brzyzek/arb/2_HARDWARE/02_BOM/brzk-arb-001-BOM.ods

LEVEL | FIND NUMBER | PART NUMBER | PART DESCRIPTION | REF DES | QUANTITY | UOM | UNIT PRICE | PRICE | VENDOR LINK | LSCS PART NUMBER | PHASE | COMMENT
1 | 0001 | brzk-arb-cca | ARBITRARY WAVEFORM GENERATOR CIRCUIT CARD ASSEMBLY | A1 | 1 | EACH | $183.86 | $183.86 |  | N/A | PROTOTYPE
2 | 0001 | brzk-arb-pcb | ARBITRARY WAVEFORM GENERATOR PRINTED CIRCUIT BOARD |  | 1 | EACH | $40.00 | $40.00 |  | N/A | PROTOTYPE
2 | 0002 | X322512MSB4SI | FOUR PIN CRYSTAL, GND ON PINS 2 AND 4, SMALL SYMBOL | Y2 | 1 | EACH | $0.67 | $0.67 | https://www.lcsc.com/product-detail/C9002.html | C9002 | COTS
2 | 0003 | Q13FC13500004 | TWO PIN CRYSTAL, SMALL SYMBOL | Y1 | 1 | EACH | $0.90 | $0.90 | https://www.lcsc.com/product-detail/C32346.html | C32346 | COTS
2 | 0004 | TS-1187A-B-A-B | PUSH BUTTON SWITCH, GENERIC, FOUR PINS | SW1 | 1 | EACH | $0.38 | $0.38 | https://www.lcsc.com/product-detail/C318884.html | C318884 | COTS
2 | 0005 | 0603WAF5101T5E | RESISTOR, SMALL US SYMBOL | R93,R94 | 2 | EACH | $0.11 | $0.22 | https://www.lcsc.com/product-detail/C23186.html | C23186 | COTS
2 | 0006 | RT0603BRE0750RL | RESISTOR, SMALL US SYMBOL | R86 | 1 | EACH | $0.18 | $0.18 | https://www.digikey.com/en/products/detail/yageo/RT0603BRE0750RL/5928059 | C849792 | COTS
2 | 0007 | 0603WAF1243T5E | RESISTOR, SMALL US SYMBOL | R83 | 1 | EACH | $0.11 | $0.11 | http://www.lcsc.com/product-detail/C22788.html | C22788 | COTS
2 | 0008 | RT0603BRD07226RL | RESISTOR, SMALL US SYMBOL | R65,R66,R67,R68 | 4 | EACH | $0.48 | $1.92 | https://www.lcsc.com/product-detail/C861234.html | C861234 | COTS
2 | 0009 | 0603WAF2001T5E | RESISTOR, SMALL US SYMBOL | R59 | 1 | EACH | $0.11 | $0.11 | https://www.lcsc.com/product-detail/C22975.html | C22975 | COTS
2 | 0010 | 0603WAF3901T5E | RESISTOR, SMALL US SYMBOL | R58 | 1 | EACH | $0.11 | $0.11 | https://www.lcsc.com/product-detail/C23018.html | C23018 | COTS
2 | 0011 | RC0603FR-074K7L | RESISTOR, SMALL US SYMBOL | R48,R76,R77 | 3 | EACH | $0.11 | $0.33 | https://www.lcsc.com/product-detail/C99782.html | C99782 | COTS
2 | 0012 | 0603WAF1202T5E | RESISTOR, SMALL US SYMBOL | R47 | 1 | EACH | $0.11 | $0.11 | https://www.lcsc.com/product-detail/C22790.html (https://www.lcsc.com/product-detail/C99782.html) | C22790 | COTS
2 | 0013 | 0603WAF2051T5E | RESISTOR, SMALL US SYMBOL | R44 | 1 | EACH | $0.11 | $0.11 | https://www.lcsc.com/product-detail/C22900.html (https://www.lcsc.com/product-detail/C99782.html) | C22900 | COTS
2 | 0014 | RC0603FR-071KL | RESISTOR, SMALL US SYMBOL | R42,R70,R72 | 3 | EACH | $0.11 | $0.33 | https://www.lcsc.com/product-detail/C22548.html (https://www.lcsc.com/product-detail/C99782.html) | C22548 | COTS
2 | 0015 | 0603WAF2200T5E | RESISTOR, SMALL US SYMBOL | R38,R39,R40,R52,R53 | 5 | EACH | $0.11 | $0.55 | https://www.lcsc.com/product-detail/C22962.html | C22962 | COTS
2 | 0016 | 0603WAF249JT5E | RESISTOR, SMALL US SYMBOL | R19,R21,R27,R28,R61,R62,R63,R64 | 8 | EACH | $0.11 | $0.88 | https://www.lcsc.com/product-detail/C22916.html | C22916 | COTS
2 | 0017 | RC0603FR-071M3L | RESISTOR, SMALL US SYMBOL | R13 | 1 | EACH | $0.10 | $0.10 | https://www.lcsc.com/product-detail/C245931.html | C245931 | COTS
2 | 0018 | RT0603DRE07104KL | RESISTOR, SMALL US SYMBOL | R12 | 1 | EACH | $0.07 | $0.07 | https://www.lcsc.com/product-detail/C862849.html | C862849 | COTS
2 | 0019 | 0603WAF8452T5E | RESISTOR, SMALL US SYMBOL | R9 | 1 | EACH | $0.01 | $0.01 | https://www.lcsc.com/product-detail/C23118.html | C23118 | COTS
2 | 0020 | 0603WAF9763T5E | RESISTOR, SMALL US SYMBOL | R8 | 1 | EACH | $0.12 | $0.12 | https://www.lcsc.com/product-detail/C48922.html | C48922 | COTS
2 | 0021 | 0603WAJ0000T5E | RESISTOR, SMALL US SYMBOL | R6,R7,R10,R11,R14,R15,R16,R17,R29,R50,R51,R73,R74,R78,R79,R80,R81,R82,R85,R91,R95,R96,R97,R98,R99,R100,R101,R102 | 28 | EACH | $0.10 | $2.80 | https://www.lcsc.com/product-detail/C15402.html | C15402 | COTS
2 | 0022 | RC0603FR-07100RL | RESISTOR, SMALL US SYMBOL | R5,R25,R26,R41 | 4 | EACH | $0.11 | $0.44 | https://www.lcsc.com/product-detail/C105588.html | C105588 | COTS
2 | 0023 | 0603WAF4990T5E | RESISTOR, SMALL US SYMBOL | R4,R69,R71,R87,R88,R89,R90 | 7 | EACH | $0.11 | $0.77 | https://www.lcsc.com/product-detail/C23065.html | C23065 | COTS
2 | 0024 | 0603WAF1002T5E | RESISTOR, SMALL US SYMBOL | R1,R2,R3,R18,R20,R22,R23,R24,R30,R31,R32,R33,R34,R35,R36,R37,R43,R45,R46,R49,R54,R55,R56,R57,R60,R75,R84,R92 | 28 | EACH | $0.10 | $2.80 | https://www.lcsc.com/product-detail/C25804.html | C25804 | COTS
2 | 0025 | LS0603-100J-N | INDUCTOR, SMALL SYMBOL | L3,L4 | 2 | EACH | $0.75 | $1.50 | https://www.lcsc.com/product-detail/C373750.html | C373750 | COTS
2 | 0026 | FTC252010S4R7MBCA,LQM18PN4R7MFRL | INDUCTOR, SMALL SYMBOL | L1,L2 | 2 | EACH | $0.50 | $1.00 | https://www.lcsc.com/product-detail/C5832360.html | C5832360,C114862 | COTS
2 | 0027 | PH-00244 | GENERIC CONNECTOR, DOUBLE ROW, 02X05, ODD/EVEN PIN NUMBERING SCHEME (ROW 1 ODD NUMBERS, ROW 2 EVEN NUMBERS), SCRIPT GENERATED (KICAD-LIBRARY-UTILS/SCHLIB/AUTOGEN/CONNECTOR/) | J5 | 1 | EACH | $0.50 | $0.50 | https://www.lcsc.com/product-detail/C2829881.html | C2829881 | COTS
2 | 0028 | DOSIN-801-0050 | COAXIAL CONNECTOR (BNC, SMA, SMB, SMC, CINCH/RCA, LEMO, ...) | J4 | 1 | EACH | $0.74 | $0.74 | https://www.lcsc.com/product-detail/C521210.html | C521210 | COTS
2 | 0029 | KH-SMA-K513-G | COAXIAL CONNECTOR (BNC, SMA, SMB, SMC, CINCH/RCA, LEMO, ...) | J2,J3 | 2 | EACH | $0.58 | $1.16 | https://www.lcsc.com/product-detail/C411575.html | C411575 | COTS
2 | 0030 | FBMA-11-160808-300A25T | FERRITE BEAD, SMALL SYMBOL | FB2 | 1 | EACH | $2.00 | $2.00 | https://jlcpcb.com/partdetail/Kingcore-FBMA_11_160808300A25T/C491547 | C491547 | COTS | NOT IN STOCK
2 | 0031 | FBMA_11_160808101A20T | FERRITE BEAD, SMALL SYMBOL | FB1 | 1 | EACH | $2.00 | $2.00 | https://jlcpcb.com/partdetail/Kingcore-FBMA_11_160808101A20T/C491555 | C491555 | COTS | NOT IN STOCK
2 | 0032 | F.1206.00003/P2-1206R1TS2-09T-001 | LIGHT EMITTING DIODE | D1,D4,D5,D6,D7,D8 | 6 | EACH | $0.10 | $0.60 | https://www.lcsc.com/product-detail/C7496845.html | C7496845 | COTS
2 | 0033 | CL10C220JB8NNNC | UNPOLARIZED CAPACITOR, SMALL SYMBOL | C110 | 1 | EACH | $0.40 | $0.40 | https://www.lcsc.com/product-detail/C1653.html | C1653 | COTS
2 | 0034 | CL10A335KP8NNNC | UNPOLARIZED CAPACITOR, SMALL SYMBOL | C77 | 1 | EACH | $0.87 | $0.87 | https://www.lcsc.com/product-detail/C51412.html | C51412 | COTS
2 | 0035 | CL10C270JB8NNNC | UNPOLARIZED CAPACITOR, SMALL SYMBOL | C73,C75 | 2 | EACH | $0.25 | $0.50 | https://www.lcsc.com/product-detail/C1656.html | C1656 | COTS
2 | 0036 | CL10C150JB8NNNC | UNPOLARIZED CAPACITOR, SMALL SYMBOL | C43,C45 | 2 | EACH | $0.25 | $0.50 | https://www.lcsc.com/product-detail/C1644.html | C1644 | COTS
2 | 0037 | CC0603CRNPO9BN5R0 | UNPOLARIZED CAPACITOR, SMALL SYMBOL | C37,C95,C96,C106,C109 | 5 | EACH | $0.10 | $0.50 | https://www.digikey.com/en/products/detail/yageo/CC0603CRNPO9BN5R0/302788 | C327203 | COTS
2 | 0038 | CL10B224KB8NNNC | UNPOLARIZED CAPACITOR, SMALL SYMBOL | C20 | 1 | EACH | $0.77 | $0.77 | https://www.lcsc.com/product-detail/C64705.html | C64705 | COTS
2 | 0039 | CC0603BRNPO9BN6R8 | UNPOLARIZED CAPACITOR, SMALL SYMBOL | C19,C21 | 2 | EACH | $0.20 | $0.40 | https://www.lcsc.com/product-detail/C519114.html | C519114 | COTS
2 | 0040 | CC0603KRX7R9BB472 | UNPOLARIZED CAPACITOR, SMALL SYMBOL | C18 | 1 | EACH | $0.26 | $0.26 | https://www.lcsc.com/product-detail/C106218.html | C106218 | COTS
2 | 0041 | CL10B103KB8NNNC | UNPOLARIZED CAPACITOR, SMALL SYMBOL | C17 | 1 | EACH | $0.16 | $0.16 | https://www.lcsc.com/product-detail/C1589.html | C1589 | COTS
2 | 0042 | CL10A225KO8NNNC | UNPOLARIZED CAPACITOR, SMALL SYMBOL | C8,C9,C10,C13,C14,C38,C39 | 7 | EACH | $0.05 | $0.35 | https://www.lcsc.com/product-detail/C23630.html | C23630 | COTS
2 | 0043 | CL10B104JB8NNNC | UNPOLARIZED CAPACITOR, SMALL SYMBOL | C6,C16,C28,C31,C32,C33,C34,C35,C36,C40,C41,C44,C46,C47,C48,C50,C51,C52,C54,C55,C56,C57,C58,C59,C60,C64,C65,C66,C67,C71,C76,C78,C79,C80,C81,C82,C83,C84,C85,C86,C87,C88,C89,C90,C91,C92,C93,C94,C97,C98,C99,C100,C101,C102,C103,C104,C105,C107,C108,C111,C112,C113,C114 | 63 | EACH | $0.01 | $0.57 | https://www.lcsc.com/product-detail/C24452.html | C24452 | COTS
2 | 0044 | CL10A475KP8NNNC | UNPOLARIZED CAPACITOR, SMALL SYMBOL | C5,C15,C22,C23,C24,C25,C26,C27,C29,C30,C61,C62,C63,C68,C69,C70,C72,C74 | 18 | EACH | $0.01 | $0.09 | https://www.lcsc.com/product-detail/C1705.html | C1705 | COTS
2 | 0045 | CL10A106KP8NNNC | UNPOLARIZED CAPACITOR, SMALL SYMBOL | C4,C42 | 2 | EACH | $0.15 | $0.30 | https://www.lcsc.com/product-detail/C19702.html | C19702 | COTS
2 | 0046 | CL10A105KB8NNNC | UNPOLARIZED CAPACITOR, SMALL SYMBOL | C1,C2,C3,C7,C11,C12,C49,C53 | 8 | EACH | $0.05 | $0.40 | https://www.lcsc.com/product-detail/C15849.html | C15849 | COTS
2 | 0047 | TPD2E001DRLR | DUAL 1.5-PF, 5.5-V, Â±8-KV ESD PROTECTION DIODE WITH 1-NA MAX LEAKAGE & VCC PIN FOR USB 2.0 | U8 | 1 | EACH | $0.90 | $0.90 | https://www.lcsc.com/product-detail/C150526.html | C150526 | COTS
2 | 0048 | TMUX6104PWR | 5-PA ON-STATE LEAKAGE CURRENT, Â±16.5-V, 4:1, 1-CHANNEL PRECISION ANALOG MULTIPLEXER | U21,U26 | 2 | EACH | $2.91 | $5.82 | https://www.lcsc.com/product-detail/C2673388.html | C2673388 | COTS
2 | 0049 | TLV76133DCYR | 3.3V, 1A, LOW NOISE, HIGH-PSRR LDO REGULATOR, 2.5V...16V INPUT, SOT-223 | U2 | 1 | EACH | $1.19 | $1.19 | https://www.lcsc.com/product-detail/C7527500.html | C7527500 | COTS
2 | 0050 | TLV70325DBVR | 300-MA, HIGH-PSRR, LOW-IQ, LOW-DROPOUT VOLTAGE REGULATOR | U6 | 1 | EACH | $1.57 | $1.57 | https://www.lcsc.com/product-detail/C2877882.html | C2877882 | COTS
2 | 0051 | TLV70312DBVR | 300-MA, HIGH-PSRR, LOW-IQ, LOW-DROPOUT VOLTAGE REGULATOR | U5 | 1 | EACH | $0.74 | $0.74 | https://www.lcsc.com/product-detail/C2861352.html | C2861352 | COTS
2 | 0052 | TLV70333DBVR | 300-MA, HIGH-PSRR, LOW-IQ, LOW-DROPOUT VOLTAGE REGULATOR | U1,U3 | 2 | EACH | $0.62 | $1.24 | https://www.lcsc.com/product-detail/C2871194.html | C2871194 | COTS
2 | 0053 | LMK1C1103PWR | 3-CHANNEL OUTPUT LVCMOS BUFFER | U10 | 1 | EACH | $1.35 | $1.35 | https://www.lcsc.com/product-detail/C2873274.html | C2873274 | COTS
2 | 0054 | STM32F446ZET7 | STMICROELECTRONICS ARM CORTEX-M4 MCU, 512KB FLASH, 128KB RAM, 180 MHZ, 1.8-3.6V, 114 GPIO, LQFP144 | U11 | 1 | EACH | $10.64 | $10.64 | https://www.digikey.com/en/products/detail/stmicroelectronics/STM32F446ZET7/6207483 | C2970508 | COTS
2 | 0055 | MBRM120ET1G | SCHOTTKY DIODE | D2,D3 | 2 | EACH | $0.76 | $1.52 | https://www.lcsc.com/product-detail/C152484.html | C152484 | COTS
2 | 0056 | BAT54LT1G | SCHOTTKY BARRIER DIODE, SOT-32 | D9 | 1 | EACH | $0.51 | $0.51 | https://www.lcsc.com/product-detail/C94399.html | C94399 | COTS
2 | 0057 | TYPE-C-31-M-12 | USB 2.0-ONLY 16P TYPE-C RECEPTACLE CONNECTOR | J1 | 1 | EACH | $0.87 | $0.87 | https://www.lcsc.com/product-detail/C165948.html | C165948 | COTS
2 | 0058 | FT2232HL | HI SPEED DOUBLE CHANNEL USB UART/FIFO, LQFP-64 | U14 | 1 | EACH | $8.68 | $8.68 | https://www.lcsc.com/product-detail/C27882.html | C27882 | COTS
2 | 0059 | ADG1219BRJZ | LOW CAPACITANCE, LOW CHARGE INJECTION, Â±15 V/12 V ICMOSÂ® SPDT IN SOT-23 | U9,U24 | 2 | EACH | $4.49 | $8.98 | https://www.lcsc.com/product-detail/C579007.html | C579007 | COTS
2 | 0060 | AD9850BRSZ | CMOS, 125 MHZ, COMPLETE DDS SYNTHESIZER, SSOP-28 | U17 | 1 | EACH | $15.26 | $15.26 | https://www.lcsc.com/product-detail/C18731.html | C18731 | COTS
2 | 0061 | AD9744ARUZRL7 | 210MSPS 14BIT DAC, TSSOP-28 | U18 | 1 | EACH | $9.47 | $9.47 | https://www.lcsc.com/product-detail/C461519.html | C461519 | COTS
2 | 0062 | W25Q128JVSIQ | 128MB SERIAL FLASH MEMORY, STANDARD/DUAL/QUAD SPI, SOIC-8 | U15,U16 | 2 | EACH | $1.14 | $2.28 | https://www.lcsc.com/product-detail/C97521.html | C97521 | COTS
2 | 0063 | TPS65131RGE | SPLIT-RAIL CONVERTER WITH DUAL, POSITIVE AND NEGATIVE OUTPUTS (750MA TYP, SWITCH CURRENT LIMIT 1950MA TYP),), 2.7-5.5V, VQFN-24 | U7 | 1 | EACH | $0.87 | $0.87 | https://www.lcsc.com/product-detail/C87663.html | C87663 | COTS
2 | 0064 | TPL0401B-10DCKR | 128-TAPS SINGLE-CHANNEL DIGITAL POTENTIOMETER, I2C INTERFACE, SC-70-6 | U22 | 1 | EACH | $1.13 | $1.13 | https://www.lcsc.com/product-detail/C2666599.html | C2666599 | COTS
2 | 0065 | THS3491IDDAR | 900-MHZ, 500-MA HIGH-POWER OUTPUT CURRENT FEEDBACK OPERATIONAL AMPLIFIER, SOIC-8 | U23 | 1 | EACH | $13.78 | $13.78 | https://www.digikey.com/en/products/detail/texas-instruments/THS3491IDDAR/8625496 | C2058693 | COTS
2 | 0066 | LM6171BIMX/NOPB | HIGH SPEED LOW POWER LOW DISTORTION VOLTAGE FEEDBACK AMPLIFIER, SOIC-8 | U19,U20,U25 | 3 | EACH | $5.21 | $15.63 | https://www.digikey.com/en/products/detail/texas-instruments/LM6171BIMX-NOPB/367300 | C2058493 | COTS
2 | 0067 | LM3880MF-1AA/NOPB | SIMPLE POWER SEQUENCER, SOT-23-6 | U4 | 1 | EACH | $0.67 | $0.67 | https://www.lcsc.com/product-detail/C486059.html | C486059 | COTS
2 | 0068 | ICE40UP5K-SG48I | ICE40 ULTRAPLUS FPGA, 5280 LUTS, 1.2V, 48-PIN QFN | U12 | 1 | EACH | $7.22 | $7.22 | https://www.lcsc.com/product-detail/C2678152.html | C2678152 | COTS
2 | 0069 | ASE-100.000MHz | 3.3V CMOS SMD CRYSTAL CLOCK OSCILLATOR, ABRACON | X2 | 1 | EACH | $2.00 | $2.00 | https://www.mouser.com/ProductDetail/ABRACON/ASE-100.000MHZ-LC-T?qs=gt1LBUVyoHkjVhbV30nHAA%3D%3D | C17666082 | COTS
2 | 0070 | ASE-10.000MHz | 3.3V CMOS SMD CRYSTAL CLOCK OSCILLATOR, ABRACON | X1 | 1 | EACH | $1.50 | $1.50 | https://www.mouser.com/ProductDetail/ABRACON/ASE-10.000MHZ-LC-T?qs=ShQ8XZQtgRupHfFA9Odmpg%3D%3D | C1995292 | COTS
2 | 0071 | 93LC56BT-I_OT | IC EEPROM 2KBIT MIC WIRE SOT23-6 | U13 | 1 | EACH | $0.45 | $0.45 | https://www.lcsc.com/product-detail/C190271.html | C190271 | COTS
2 | 9001 | brzk-arb-001-sch | ARBITRARY WAVEFORM GENERATOR SCHEMATIC |  | 0 | REF | $0.00 | $0.00 | N/A | N/A | PROTOTYPE
