brzyzek/arb/2_HARDWARE/04_PINS/ARB_PIN_MAP.ods

Sheet: MCU
PIN NUMBER | PIN NAME | PIN TYPE | SIGNAL NAME | SIGNAL TYPE | VOLTAGE | DIRECTION (IAW STM32) | STM32 RESOURCE | COMMENTS
1 | PE2 | I/O | QSPI_IO2_MCU_FLASH_3P3 | LVCMOS33 | 3.3 | BIDIR | QUADSPI_BK1_IO2
2 | PE3 | I/O | NC
3 | PE4 | I/O | NC
4 | PE5 | I/O | NC
5 | PE6 | I/O | NC
6 | VBAT | Power | 3P3V_D | POWER | 3.3 | IN | VBAT
7 | PC13 | I/O | NC
8 | PC14-OSC32_IN | I/O | CLK_32K_OSC_MCU_IN | OSCILLATOR | X | IN | 32KHZ OSCILLATOR
9 | PC15-OSC32_OUT | I/O | CLK_32K_OSC_MCU_OUT | OSCILLATOR | X | OUT | 32KHZ OSCILLATOR
10 | PF0 | I/O | NC
11 | PF1 | I/O | NC
12 | PF2 | I/O | NC
13 | PF3 | I/O | NC
14 | PF4 | I/O | NC
15 | PF5 | I/O | NC
16 | VSS | Power | GND_D | GROUND | 0 | IN | GROUND
17 | VDD | Power | 3P3V_D | POWER | 3.3 | IN | POWER
18 | PF6 | I/O | QSPI_IO3_MCU_FLASH_3P3 | LVCMOS33 | 3.3 | BIDIR | QUADSPI_BK1_IO3
19 | PF7 | I/O | NC
20 | PF8 | I/O | QSPI_IO0_MCU_FLASH_3P3 | LVCMOS33 | 3.3 | BIDIR | QUADSPI_BK1_IO0
21 | PF9 | I/O | QSPI_IO1_MCU_FLASH_3P3 | LVCMOS33 | 3.3 | BIDIR | QUADSPI_BK1_IO1
22 | PF10 | I/O | NC
23 | PH0-OSC_IN | I/O | CLK_10MHZ_DIST_MCU_3P3 | LVCMOS33 | 3.3 | IN | OSCILLATOR IN
24 | PH1-OSC_OUT | I/O | NC
25 | NRST | Reset | GPIO_RST_MCU_3P3_L | LVCMOS33 | 3.3 | IN | NRST | SEND TO SWITCH THAT GNDS, NORMALLY PULLED UP TO VDD
26 | PC0 | I/O | SPI_CS_MCU_FPGA_3P3_L | LVCMOS33 | 3.3 | OUT | GPIO_OUT | USED FOR SPI1 CHIP SELECT TO FPGA
27 | PC1 | I/O | SPI_MOSI_MCU_FPGA_3P3 | LVCMOS33 | 3.3 | OUT | SPI2_MOSI
28 | PC2 | I/O | SPI_MISO_FPGA_MCU_3P3 | LVCMOS33 | 3.3 | IN | SPI2_MISO
29 | PC3 | I/O | SPI_CS_MCU_FLASH_3P3_L | LVCMOS33 | 3.3 | OUT | GPIO_OUT | USED FOR SPI1 CHIP SELECT TO FLASH
30 | VDD | Power | 3P3V_D | POWER | 3.3 | IN | POWER
31 | VSSA | Power | GND_A | GROUND | 0 | IN | GROUND
32 | VREF+ | Power | 3P3V_D | POWER | 3.3 | IN | POWER
33 | VDDA | Power | 3P3V_A | POWER | 3.3 | IN | POWER
34 | PA0-WKUP | I/O | NC
35 | PA1 | I/O | NC
36 | PA2 | I/O | UART_MCUTX_FTDIRX_3P3 | LVCMOS33 | 3.3 | OUT | USART2_TX
37 | PA3 | I/O | UART_FTDITX_MCURX_3P3 | LVCMOS33 | 3.3 | IN | USART2_RX
38 | VSS | Power | GND_D | GROUND | 0 | IN | GROUND
39 | VDD | Power | 3P3V_D | POWER | 3.3 | IN | POWER
40 | PA4 | I/O | ANALOG_DAC1_MCU_AMUX1 | ANALOG | 0V TO 3V | OUT | DAC_OUT1
41 | PA5 | I/O | ANALOG_DAC2_MCU_AMUX3 | ANALOG | 0V TO 3V | OUT | DAC_OUT2
42 | PA6 | I/O | ANALOG_CAL-ADC_AMUX2_MCU | ANALOG | 0V TO 3V | IN | ADC1_IN6
43 | PA7 | I/O | GPIO_SEL1_MCU_AMUX3_3P3 | LVCMOS33 | 3.3 | OUT | GPIO_OUT
44 | PC4 | I/O | NC
45 | PC5 | I/O | NC
46 | PB0 | I/O | NC
47 | PB1 | I/O | NC
48 | PB2 | I/O | GPIO_BOOT1_SW_MCU_3P3_L QSPI_CLK_MCU_FLASH_3P3 | LVCMOS33 | 3.3 | IN OUT | BOOT1 QUADSPI_CLK
49 | PF11 | I/O | GPIO_CFG_DONE_FPGA_MCU_3P3 | LVCMOS33 | 3.3 | IN | GPIO_IN
50 | PF12 | I/O | GPIO_FPGARST_MCU_FPGA_3P3_L | LVCMOS33 | 3.3 | OUT | GPIO_OUT
51 | VSS | Power | GND_D | GROUND | 0 | IN | GROUND
52 | VDD | Power | 3P3V_D | POWER | 3.3 | IN | POWER
53 | PF13 | I/O | NC
54 | PF14 | I/O | GPIO_CLK_EN_MCU_FPGA_3P3 | LVCMOS33 | 3.3 | OUT | GPIO_OUT
55 | PF15 | I/O | GPIO_AMP-PD_MCU_AMP2_3P3 | LVCMOS33 | 3.3 | OUT | GPIO_OUT
56 | PG0 | I/O | NC
57 | PG1 | I/O | NC
58 | PE7 | I/O | NC
59 | PE8 | I/O | NC
60 | PE9 | I/O | NC
61 | VSS | Power | GND_D | GROUND | 0 | IN | GROUND
62 | VDD | Power | 3P3V_D | POWER | 3.3 | IN | POWER
63 | PE10 | I/O | NC
64 | PE11 | I/O | GPIO_SEL0_MCU_AMUX3_3P3 | LVCMOS33 | 3.3 | OUT | GPIO_OUT
65 | PE12 | I/O | GPIO_EN_MCU_AMUX3_3P3 | LVCMOS33 | 3.3 | OUT | GPIO_OUT
66 | PE13 | I/O | GPIO_EN_MCU_AMUX2_3P3 | LVCMOS33 | 3.3 | OUT | GPIO_OUT
67 | PE14 | I/O | GPIO_SEL_MCU_AMUX2_3P3 | LVCMOS33 | 3.3 | OUT | GPIO_OUT
68 | PE15 | I/O | NC
69 | PB10 | I/O | I2C_SCL_MCU_POT_3P3 | LVCMOS33 | 3.3 | OUT | I2C1_SCL
70 | PB11 | I/O | I2C_SDA_MCU_POT_3P3 | LVCMOS33 | 3.3 | BIDIR | I2C1_SDA
71 | VCAP_1 | Power | GND_D | GROUND | 0 | IN | GROUND | GND THROUGH 2.2UF CAPACITOR
72 | VDD | Power | 3P3V_D | POWER | 3.3 | IN | POWER
73 | PB12 | I/O | GPIO_100M-EN_MCU_100M-OSC_3P3 | LVCMOS33 | 3.3 | OUT | GPIO_OUT
74 | PB13 | I/O | SPI_SCLK_MCU_FPGA_3P3 | LVCMOS33 | 3.3 | OUT | SPI2_SCK
75 | PB14 | I/O | GPIO_RST_MCU_DDS_3P3 | LVCMOS33 | 3.3 | OUT | GPIO_OUT
76 | PB15 | I/O | GPIO_D7_MCU_DDS_3P3 | LVCMOS33 | 3.3 | OUT | GPIO_OUT
77 | PD8 | I/O | GPIO_D6_MCU_DDS_3P3 | LVCMOS33 | 3.3 | OUT | GPIO_OUT
78 | PD9 | I/O | GPIO_D5_MCU_DDS_3P3 | LVCMOS33 | 3.3 | OUT | GPIO_OUT
79 | PD10 | I/O | GPIO_D4_MCU_DDS_3P3 | LVCMOS33 | 3.3 | OUT | GPIO_OUT
80 | PD11 | I/O | GPIO_D1_MCU_DDS_3P3 | LVCMOS33 | 3.3 | OUT
81 | PD12 | I/O | GPIO_D2_MCU_DDS_3P3 | LVCMOS33 | 3.3 | OUT
82 | PD13 | I/O | NC
83 | VSS | Power | GND_D | GROUND | 0 | IN | GROUND
84 | VDD | Power | 3P3V_D | POWER | 3.3 | IN | POWER
85 | PD14 | I/O | NC
86 | PD15 | I/O | NC
87 | PG2 | I/O | GPIO_FQ-UD_MCU_DDS_3P3 | LVCMOS33 | 3.3 | OUT | GPIO_OUT
88 | PG3 | I/O | GPIO_D0_MCU_DDS_3P3 | LVCMOS33 | 3.3 | OUT | GPIO_OUT
89 | PG4 | I/O | NC |  |  |  | GPIO_OUT
90 | PG5 | I/O | NC |  |  |  | GPIO_OUT
91 | PG6 | I/O | QSPI_NCS_MCU_FLASH_3P3 | LVCMOS33 | 3.3 | OUT | QUADSPI_BK1_NCS
92 | PG7 | I/O | NC
93 | PG8 | I/O | NC
94 | VSS | Power | GND_D | GROUND | 0 | IN | GROUND
95 | VDDUSB | Power | 3P3V_D | POWER | 3.3 | IN | POWER
96 | PC6 | I/O | NC
97 | PC7 | I/O | NC
98 | PC8 | I/O | NC
99 | PC9 | I/O | NC
100 | PA8 | I/O | NC
101 | PA9 | I/O | NC
102 | PA10 | I/O | NC
103 | PA11 | I/O | GPIO_D3_MCU_DDS_3P3 | LVCMOS33 | 3.3 | OUT | GPIO_OUT
104 | PA12 | I/O | GPIO_W-CLK_MCU_DDS_3P3 | LVCMOS33 | 3.3 | OUT | GPIO_OUT
105 | PA13 | I/O | JTAG_MCU_TMS_3P3 | LVCMOS33 | 3.3 | IN | JTAG_TMS
106 | VCAP_2 | Power | GND_D | GROUND | 0 | IN | GROUND | GND THROUGH 2.2UF CAPACITOR
107 | VSS | Power | GND_D | GROUND | 0 | IN | GROUND
108 | VDD | Power | 3P3V_D | POWER | 3.3 | IN | POWER
109 | PA14 | I/O | JTAG_MCU_TCK_3P3 | LVCMOS33 | 3.3 | IN | JTAG_TCK
110 | PA15 | I/O | JTAG_MCU_TDI_3P3 | LVCMOS33 | 3.3 | IN | JTAG_TDI
111 | PC10 | I/O | NC
112 | PC11 | I/O | GPIO_SW-SEL_MCU_CLKMUX_3P3 | LVCMOS33 | 3.3 | OUT | GPIO_OUT
113 | PC12 | I/O | NC
114 | PD0 | I/O | NC
115 | PD1 | I/O | NC
116 | PD2 | I/O | NC
117 | PD3 | I/O | NC
118 | PD4 | I/O | NC
119 | PD5 | I/O | NC
120 | VSS | Power | GND_D | GROUND | 0 | IN | POWER
121 | VDD | Power | 3P3V_D | POWER | 3.3 | IN | POWER
122 | PD6 | I/O | GPIO_SEL1_MCU_AMUX1_3P3 | LVCMOS33 | 3.3 | OUT | GPIO_OUT
123 | PD7 | I/O | GPIO_SEL0_MCU_AMUX1_3P3 | LVCMOS33 | 3.3 | OUT | GPIO_OUT
124 | PG9 | I/O | NC
125 | PG10 | I/O | NC
126 | PG11 | I/O | NC
127 | PG12 | I/O | GPIO_EN_MCU_AMUX1_3P3 | LVCMOS33 | 3.3 | OUT | GPIO_OUT
128 | PG13 | I/O | NC
129 | PG14 | I/O | NC
130 | VSS | Power | GND_D | GROUND | 0 | IN | POWER
131 | VDD | Power | 3P3V_D | POWER | 3.3 | IN | POWER
132 | PG15 | I/O | NC
133 | PB3 | I/O | JTAG_MCU_TDO_3P3 | LVCMOS33 | 3.3 | OUT | JTAG_TDO
134 | PB4 | I/O | NC
135 | PB5 | I/O | NC
136 | PB6 | I/O | NC
137 | PB7 | I/O | NC
138 | BOOT0 | Boot | GPIO_BOOT0_SW_MCU_3P3_L | LVCMOS33 | 3.3 | IN | BOOT0 | CHECK IF WE NEED TO PULL THIS HIGH OR IF IT’S PULLED INTERNALLY
139 | PB8 | I/O | NC
140 | PB9 | I/O | NC
141 | PE0 | I/O | NC
142 | PE1 | I/O | NC
143 | PDR_ON | Reset | GPIO_PDRON_SW_MCU_3P3_L | LVCMOS33 | 3.3 | IN | POWER DOWN RESET | PULL UP TO VDD THROUGH 10K RES
144 | VDD | Power | 3P3V_D | POWER | 3.3 | IN | POWER

Sheet: FPGA
PIN NUMBER | PIN NAME | PIN TYPE | SIGNAL NAME | SIGNAL TYPE | VOLTAGE | DIRECTION (IAW FPGA) | DIFFERNETIAL PAIR | FPGA BANK | COMMENTS
1 | VCCIO_2 | VCCIO | 3P3V_D | POWER | 3.3 | IN | COMP_of_IOB_8a | 2
2 | IOB_6a | PIO | NC |  | 3.3 |  | TRUE_of_IOB_9b | 2
3 | IOB_9b | DPIO | NC |  | 3.3 |  | N/A | 2
4 | IOB_8a | DPIO | NC |  | 3.3 |  | COMP_of_IOB_12a | 2
5 | VCC | VCC | 1P2V_D | POWER | 1.2 | IN | N/A | VCC
6 | IOB_13b | DPIO | NC |  | 3.3 |  | N/A | 1
7 | CDONE | CONFIG | GPIO_CFG_DONE_FPGA_MCU_3P3 | LVCMOS33 | 3.3 | OUT | N/A | 1 | Send to MCU
8 | creset_b | CONFIG | GPIO_FPGARST_MCU_FPGA_3P3_L | LVCMOS33 | 3.3 | IN | N/A | 1 | Send to MCU (tied to SPI_VCCIO)
9 | IOB_16a | PIO | NC |  | 3.3 |  | N/A | 1
10 | IOB_18a | PIO | NC |  | 3.3 |  | TRUE_of_IOB_23b | 1
11 | IOB_20a | PIO | NC |  | 3.3 |  | TRUE_of_IOB_25b | 1
12 | IOB_22a | DPIO | GPIO_DACB11_FPGA_DAC_3P3 | LVCMOS33 | 3.3 | OUT | N/A | 1
13 | IOB_24a | DPIO | GPIO_DACSLEEP_FPGA_DAC_3P3 | LVCMOS33 | 3.3 | OUT | N/A | 1 | ACTIVE HIGH TO SLEEP, DAC HAS PULL DOWN CIRCUIT,
14 | IOB_32a_SPI_SO | DPIO/CONFIG_SPI | SPI_MISO_FPGA_MCU_3P3 | LVCMOS33 | 3.3 | OUT | N/A | 1 | Send to MCU + FLASH
15 | IOB_34a_SPI_SCK | DPIO/CONFIG_SPI | SPI_SCLK_MCU_FPGA_3P3 | LVCMOS33 | 3.3 | IN | N/A | 1 | Send to MCU + FLASH
16 | IOB_35b_SPI_SS | DPIO/CONFIG_SPI | SPI_CS_MCU_FPGA_3P3_L | LVCMOS33 | 3.3 | IN | N/A | 1 | Send to MCU + FLASH
17 | IOB_33b_SPI_SI | DPIO/CONFIG_SPI | SPI_MOSI_MCU_FPGA_3P3 | LVCMOS33 | 3.3 | IN | N/A | 1 | Send to MCU + FLASH
18 | IOB_31b | PIO | NC |  | 3.3 |  | COMP_of_IOB_24a | 1
19 | IOB_29b | PIO | NC |  | 3.3 |  | COMP_of_IOB_22a | 1
20 | IOB_25b_G3 | DPIO/GBIN | NC |  | 3.3 |  | N/A | 1
21 | IOB_23b | DPIO | NC |  | 3.3 |  | TRUE_of_IOT_36b | 1
22 | SPI_Vccio1 | VCCIO | 3P3V_D | POWER | 3.3 | IN | N/A | 1
23 | IOT_37a | DPIO/I3C | NC |  | 3.3 |  | COMP_of_IOT_37a | 0
24 | VPP_2V5 | VPP | 2P5V_D | POWER | 2.5 | IN | TRUE_of_IOT_38b | VPP
25 | IOT_36b | DPIO/I3C | GPIO_DACB0_FPGA_DAC_3P3 | LVCMOS33 | 3.3 | OUT | COMP_of_IOT_39a | 0
26 | IOT_39a | DPIO | GPIO_DACB1_FPGA_DAC_3P3 | LVCMOS33 | 3.3 | OUT | N/A | 0
27 | IOT_38b | DPIO | GPIO_DACB2_FPGA_DAC_3P3 | LVCMOS33 | 3.3 | OUT | N/A | 0
28 | IOT_41a | PIO | GPIO_DACB3_FPGA_DAC_3P3 | LVCMOS33 | 3.3 | OUT | N/A | 0
29 | VCCPLL | VCCPLL | 1P2V_D | POWER | 1.2 | IN | COMP_of_IOT_43a
30 | VCC | VCC | 1P2V_D | POWER | 1.2 | IN | TRUE_of_IOT_42b | VCC
31 | IOT_42b | DPIO | GPIO_DACB4_FPGA_DAC_3P3 | LVCMOS33 | 3.3 | OUT | N/A | 0
32 | IOT_43a | DPIO | NC |  | 3.3 |  | COMP_of_IOT_45a | 0
33 | VCCIO_0 | VCCIO | 3P3V_D | POWER | 3.3 | IN | N/A | 0
34 | IOT_44b | DPIO | GPIO_DACB5_FPGA_DAC_3P3 | LVCMOS33 | 3.3 | OUT | COMP_of_IOT_49a | 0
35 | IOT_46b_G0 | DPIO/GBIN | CLK_10MHZ_DIST_FPGA_3P3 | LVCMOS33 | 3.3 | IN | TRUE_of_IOT_44b | 0 | G0 as Global Clock Buffer In
36 | IOT_48b | DPIO | GPIO_DACB6_FPGA_DAC_3P3 | LVCMOS33 | 3.3 | OUT | COMP_of_IOT_51a | 0
37 | IOT_45a_G1 | DPIO/GBIN | GPIO_CLK_EN_MCU_FPGA_3P3 | LVCMOS33 | 3.3 | IN | N/A | 0
38 | IOT_50b | DPIO | GPIO_DACB7_FPGA_DAC_3P3 | LVCMOS33 | 3.3 | OUT | N/A | 0
39 | RGB0 | LED | GPIO_LED0_FPGA_LED_OD | OPEN DRAIN | 3.3 | OUT | N/A | 0 | Connect to Status LED
40 | RGB1 | LED | GPIO_LED1_FPGA_LED_OD | OPEN DRAIN | 3.3 | OUT | TRUE_of_IOT_50b | 0 | Connect to Status LED
41 | RGB2 | LED | GPIO_LED2_FPGA_LED_OD | OPEN DRAIN | 3.3 | OUT | TRUE_of_IOT_48b | 0 | Connect to Status LED
42 | IOT_51a | DPIO | GPIO_DACB8_FPGA_DAC_3P3 | LVCMOS33 | 3.3 | OUT | COMP_of_IOB_2a | 0
43 | IOT_49a | DPIO | GPIO_DACB9_FPGA_DAC_3P3 | LVCMOS33 | 3.3 | OUT | COMP_of_IOB_4a | 0
44 | IOB_3b_G6 | DPIO/GBIN | GPIO_DACB13_FPGA_DAC_3P3 | LVCMOS33 | 3.3 | OUT | N/A | 2
45 | IOB_5b | DPIO | GPIO_DACB12_FPGA_DAC_3P3 | LVCMOS33 | 3.3 | OUT | TRUE_of_IOB_3b | 2
46 | IOB_0a | PIO | NC |  | 3.3 |  | TRUE_of_IOB_5b | 2
47 | IOB_2a | DPIO | GPIO_DACCLK_FPGA_DAC_3P3 | LVCMOS33 | 3.3 | OUT | TRUE_of_IOB_11b | 2
48 | IOB_4a | DPIO | GPIO_DACB10_FPGA_DAC_3P3 | LVCMOS33 | 3.3 | OUT | COMP_of_IOB_10a | 2
Paddle | GND | GND | GND_D | GROUND | 0 |  | N/A | GND
Paddle | GND | GND | GND_D | GROUND | 0 |  | N/A | GND
Paddle | GND | GND | GND_D | GROUND | 0 |  | N/A | GND
 |  | Note: PIO = Programmable IO, DPIO = Differntial PIO, GBIN = Global In
