brzyzek/arb/2_HARDWARE/06_ANALYSIS/02_POWER_CONSUMPTION/POWER_ANALYSIS.ods

PART NUMBER | DESCRIPTION | REFERENCE DESIGNATOR | QUANTITY | 3P3V DIGITAL | 3P3V_FPGA | 3P3V ANALOG | 2P5V DIGITAL | 1P2V DIGITAL | 1P8V DIGITAL | 15V ANALOG | -15V ANALOG | COMMENTS
TOTAL CURRENT DRAW (A) |  |  |  | 0.48445 | 0.00030 | 0.10200 | 0.00010 | 0.00300 | 0.00000 | 0.26254 | 0.26254
TBD | LED | D1,D2 | 2 | 0.02000
TBD | RESISTOR, 10K OHMS | R1,R5,R7,R9,R12,R?,R?,R?,R?,R?,R? | 11 | 0.00132
TBD | RESISTOR, 1K OHMS | R8,R?,R? | 3 | 0.00330
TBD | RESISTOR, 4.7K OHMS | R11 | 1 | 0.00281
LM3880 | POWER SEQUENCER | U1 | 1 | 0.00003
ICE40UP5K-SG48ITR | FPGA, LATTICE ICE40UPK | U2 | 1 |  | 0.00030 |  | 0.00010 | 0.00300
STM32F446ZETx | MCU, STM32F446 | U3 | 1 | 0.24000 |  | 0.00100
AD9744 | DAC (FPGA) | U7 | 1 | 0.01500 |  | 0.03600 |  |  |  |  |  | MAY HAVE TO COMBINE THE ANALOG AND DIGITAL CURRENT NUMBERS
TMUX6104 | ANALOG MUX, SP4T | U?,U? | 2 |  |  |  |  |  |  | 0.00003 | 0.00003
THS34911DDA | OP-AMP, STAGE 2HIGH POWER | U? | 1 |  |  |  |  |  |  | 0.22500 | 0.22500 | PROBABLY < 150MA (INCL 17MA QUIESCENT CURRENT)
TPL0401B-10 | DIGITAL POTENTIOMETER | U? | 1 |  |  | 0.00500
LM6171D | OP-AMP, STAGE 1 | U?,U?,U? | 3 |  |  |  |  |  |  | 0.03750 | 0.03750 | PROBABLY < 150MA (INCL 2.5MA QUIESCENT CURRENT)
AD9850 | DAC (DDS) | U? | 1 | 0.00500 |  | 0.06000
93LC56BT-I_OT | EEPROM, FTDI | U? | 1 | 0.00100
FT2232HL | USB COMMUNICATION, FTDI | U? | 1 | 0.15000
ADG1219BRJZ | ANALOG MUX, SPDT | U?,U? | 2 |  |  |  |  |  |  | 0.00001 | 0.00001
ASE-100.000MHz | OSCILLATOR, 100MHZ | X? | 1 | 0.02500 |  |  |  |  |  |  |  | THIS MAY HAVE TO BE MOVED TO 3P3V ANALOG
ASE-10.000MHz | OSCILLATOR, 10MHZ | X? | 1 | 0.00700
TBD | OSCILLATOR, 32.768KHZ | Y2 | 1 | 0.00700
TBD | OSCILLATOR, 12MHZ | Y3 | 1 | 0.00700
