brzyzek/arb/2_HARDWARE/06_ANALYSIS/01_OP_AMP_SELECTION/OP_AMPS.ods

PART NUMBER | POWER SUPPLY VOLTAGE SPAN | INPUT VOLTAGE RANGE | OUTPUT VOLTAGE RANGE | OUTPUT CURRENT (mA) | SLEW RATE (V/US) | BW (-3DB) | UNITY GAIN STABLE | LINK
ADA4857-1 | 10.5 | -4V TO +4 | -VS+1.3 TO VS-1.3 | 50 | 2800 | 850M | Y | https://www.analog.com/en/ada4857-1
AD8012 | 12 | -5V TO +5 | -VS+1 TO VS-1 | 125 | 2250 | 350M | ? | https://www.analog.com/en/ad8012
LTC6268-10 |  |  |  |  |  |  | GAIN > 10 STABLE | https://www.analog.com/en/products/ltc6268-10.html#part-details
LT6553
ada4870
AD8016
 | https://www.analog.com/en/parametricsearch/11070#/p300=1k|5.5k&sort=s25,desc&d=s25|s6|s3|5002|4502|2606|300|2687|5055|2839|2840|5057|s16
 | ANALOG WITH PARAMETERS
