brzyzek/arb/2_HARDWARE/05_SIMULATION/analog.asc

I1: current; SINE(5M 5M 100Meg 0 0 180)
I3: current; SINE(5M 5M 100Meg)
R1: res; 499
R2: res; 499
R3: res; 1K
R4: res; 1K
R5: res; 120
R6: res; 50
R7: res; 50
R8: res; 120
R9: res; 1500
R10: res; 50
R11: res; 499
R12: res; 499
R13: res; 499
R14: res; 499
U1: UniversalOpAmp2; Avol=1Meg GBW=8000Meg Slew=8000Meg; Ilimit=50M Rail=0 Vos=0
U2: UniversalOpAmp2; Avol=1Meg GBW=8000Meg Slew=8000Meg; Ilimit=1 Rail=0 Vos=0
U3: UniversalOpAmp2; Avol=1Meg GBW=8000Meg Slew=8000Meg; Ilimit=50M Rail=0 Vos=0
V1: voltage; 5
V2: voltage; 5
V3: voltage; 12
V4: voltage; 12
V5: voltage; 3.3
V6: voltage; 3.1
V7: voltage; 2.0
V8: voltage; 15
V9: voltage; 15
Named nets: 0, N5V0, 5V0, 15V0, N15V0, N12V0, 12V0
.tran .001s
DIFFERENTIAL TO SINGLE ENDED OUTPUT AT +/- 1V
INVERTING BUFFER /W 5X GAIN (R9 SHOULD BE A DIFFERENTIAL POT)
3.3V REF
DAC REF
VOLTAGE OUTPUT = DAC REF - 3.3
DAC REF
