brzyzek/arb/2_HARDWARE/05_SIMULATION/DAC.asc

R1: res; 50R
U1: AD5770R
V1: voltage; 3.3
V2: voltage; 3.3
Named nets: 0
.tran 1s startup
ADDED AD5770R TO BE SIMILAR TO AD9744.
