brzyzek/arb/2_HARDWARE/05_SIMULATION/RVP+ATTN.asc

D1: diode
R1: res; 50K
R2: res; 1K
R3: res; 124K
R4: res; 500K
R15: res; 50
V1: voltage; SINE(0 12 100Meg)
V2: voltage; SINE(0 12 100Meg); Rser=2 Cpar=5p
Named nets: 0
.tran .001s
RIN @ ADC IS 50K OHMS
