brzyzek/arb/2_HARDWARE/05_SIMULATION/analog_noninvopamp.asc

I3: current; SINE(10M 10M 100Meg)
R3: res; 1K
R4: res; 2K
R5: res; 50R
U1: ADA4857
V1: voltage; 5
V2: voltage; 5
Named nets: 0, N5V0, 5V0
.tran .001s
