brzyzek/arb/2_HARDWARE/03_PCB/arb.kicad_pcb

## KiCad design 2_HARDWARE/03_PCB/arb.kicad_pcb (2025-10-13)

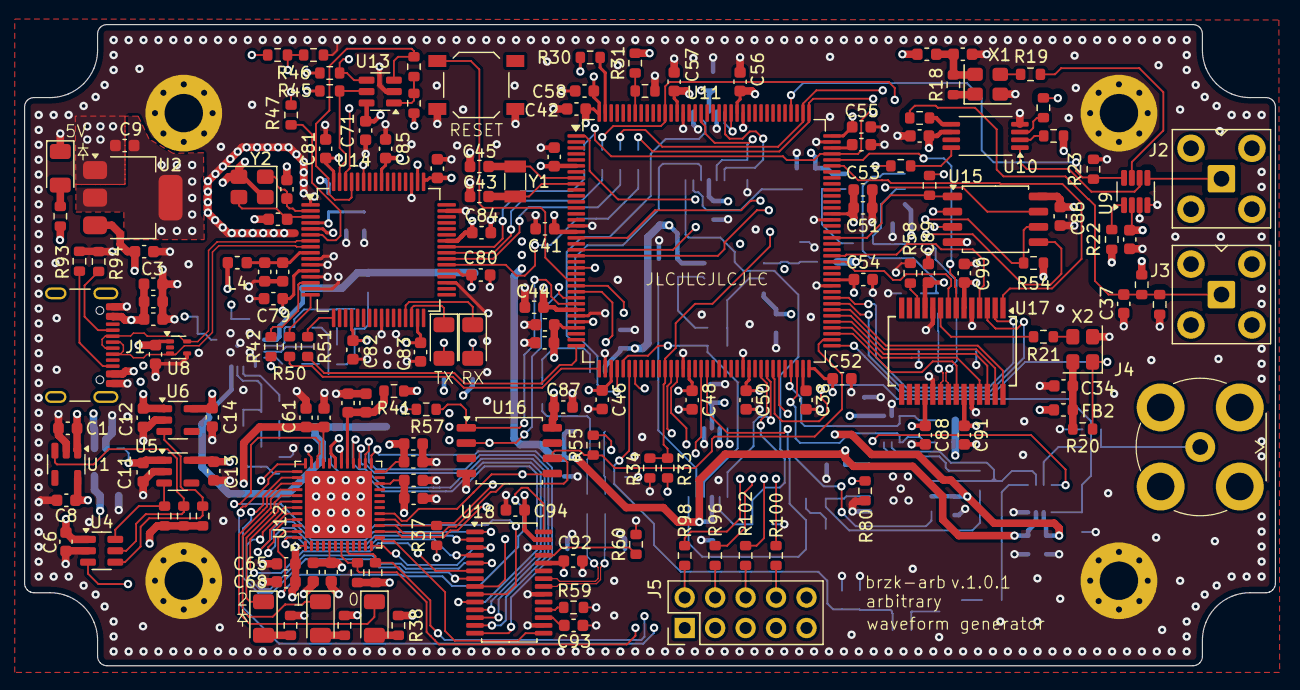
[picture p1: board arb.kicad_pcb from above]

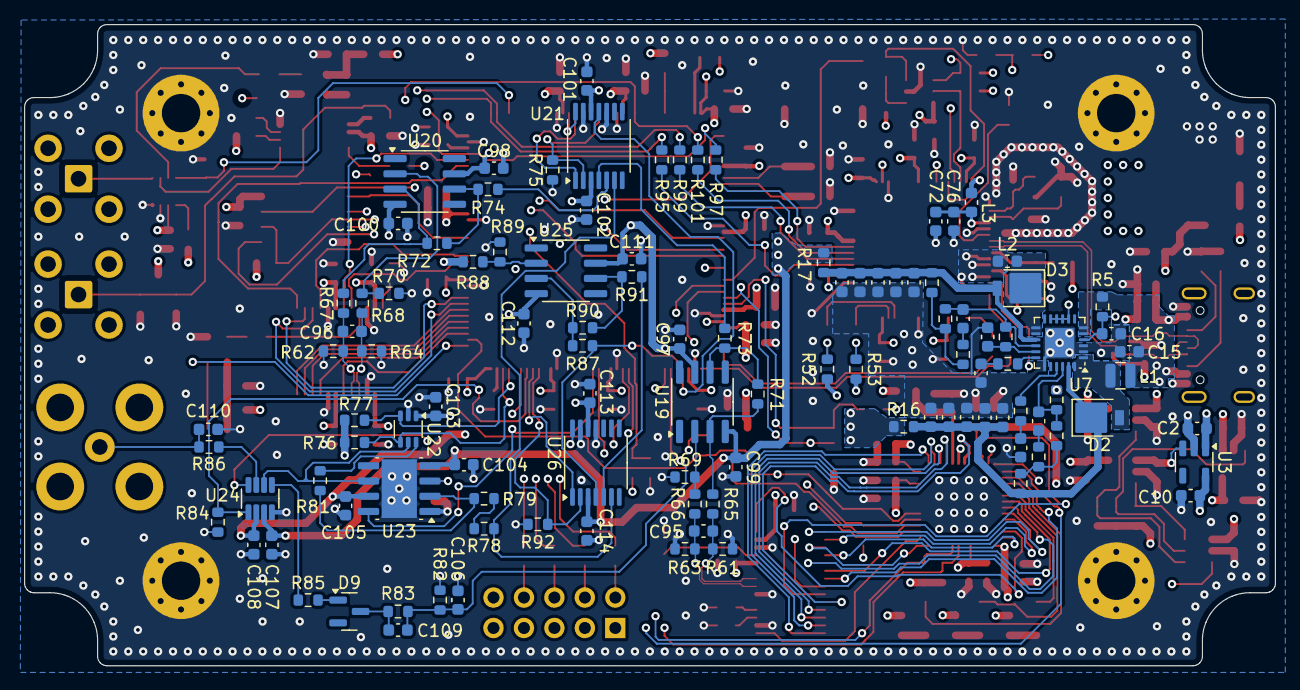
[picture p2: board arb.kicad_pcb from below]

Board: 6 copper layers, 104.3 x 53.5 mm, 271 parts (107 on the bottom side), 184 nets.

Parts:
C1, C2, C3, C7, C11, C12, C49, C53: 1u; C_0603_1608Metric
C4, C42: 10u; C_0603_1608Metric
C5, C15, C22, C23, C24, C25, C26, C27, C29, C30, C61, C62, C63, C68, C69, C70, C72, C74: 4.7u; C_0603_1608Metric
C6, C16, C28, C31, C32, C33, C34, C35, C36, C40, C41, C44, C46, C47, C48, C50, C51, C52, C54, C55, C56, C57, C58, C59, C60, C64, C65, C66, C67, C71, C76, C78, C79, C80, C81, C82, C83, C84, C85, C86, C87, C88, C89, C90, C91, C92, C93, C94, C97, C98, C99, C100, C101, C102, C103, C104, C105, C107, C108, C111, C112, C113, C114: 100n; C_0603_1608Metric
C8, C9, C10, C13, C14, C38, C39: 2.2u; C_0603_1608Metric
C17: 10n; C_0603_1608Metric
C18: 4.7n; C_0603_1608Metric
C19, C21: 6.8p; C_0603_1608Metric
C20: 220n; C_0603_1608Metric
C37, C95, C96, C106, C109: 5p; C_0603_1608Metric
C43, C45: 15p; C_0603_1608Metric
C73, C75: 27p; C_0603_1608Metric
C77: 3.3u; C_0603_1608Metric
C110: 22p; C_0603_1608Metric
D1, D4, D5, D6, D7, D8: LED; LED_1206_3216Metric
D2, D3: MBRM120ET1G; D_SMP_DO-216AA
D9: BAT54L; SOT-23
FB1: 100@100MHz; L_0603_1608Metric
FB2: 30@100MHz; L_0603_1608Metric
H1, H2, H3, H4: MOUNTING HOLE; MountingHole_3.2mm_M3_Pad_Via
J1: TYPE-C-31-M-12; USB_C_Receptacle_GCT_USB4105-xx-A_16P_TopMnt_Horizontal
J2, J3: SMA; SMA_TH_Horizontal_KH-SMA-K513-G
J4: BNC; BNC_TH_Horizontal_DOSIN-801-0050
J5: PH-00244; PinHeader_2x05_P2.54mm_Vertical
L1: 4.7u; L_SMD_L2.5_W2.0_Metric
L2: 4.7u; L_0603_1608Metric
L3, L4: 10u; L_0603_1608Metric
R1, R2, R3, R18, R20, R22, R23, R24, R30, R31, R32, R33, R34, R35, R36, R37, R43, R45, R46, R49, R54, R55, R56, R57, R60, R75, R84, R92: 10k; R_0603_1608Metric
R4, R69, R71, R87, R88, R89, R90: 499; R_0603_1608Metric
R5, R25, R26, R41: 100; R_0603_1608Metric
R6, R7, R10, R11, R14, R15, R16, R17, R29, R50, R51, R73, R74, R78, R79, R80, R81, R82, R85, R91, R95, R96, R97, R98, R99, R100, R101, R102: 0; R_0603_1608Metric
R8: 976k; R_0603_1608Metric
R9: 84.5k; R_0603_1608Metric
R12: 104k; R_0603_1608Metric
R13: 1.30M; R_0603_1608Metric
R19, R21, R27, R28, R61, R62, R63, R64: 24.9; R_0603_1608Metric
R38, R39, R40, R52, R53: 220; R_0603_1608Metric
R42, R70, R72: 1k; R_0603_1608Metric
R44: 2.05k; R_0603_1608Metric
R47: 12k; R_0603_1608Metric
R48, R76, R77: 4.7k; R_0603_1608Metric
R58: 3.9k; R_0603_1608Metric
R59: 2k; R_0603_1608Metric
R65, R66, R67, R68: 226; R_0603_1608Metric
R83: 124k; R_0603_1608Metric
R86: 50; R_0603_1608Metric
R93, R94: 5.1k; R_0603_1608Metric
SW1: TS-1187A-B-A-B; SW_SPST_BUTTON_TS-1187A-B-A-B
U1, U3: TLV70333DBV; SOT-23-5
U2: TLV76133DCY; SOT-223-3_TabPin2
U4: LM3880MF-1AA; SOT-23-6
U5: TLV70312DBV; SOT-23-5
U6: TLV70325DBV; SOT-23-5
U7: TPS65131RGE; VQFN-24-1EP_4x4mm_P0.5mm_EP2.45x2.45mm
U8: TPD2E001DRL; SOT-553
U9, U24: ADG1219BRJZ; SOT-23-8
U10: LMK1C1103PWR; TSSOP-8_4.4x3mm_P0.65mm
U11: STM32F446ZETx; LQFP-144_20x20mm_P0.5mm
U12: ICE40UP5K-SG48ITR; QFN-48-1EP_7x7mm_P0.5mm_EP5.6x5.6mm
U13: 93LC56BT-I_OT; SOT-23-6
U14: FT2232HL; LQFP-64_10x10mm_P0.5mm
U15, U16: W25Q128JVSIQ; SOIC-8_5.3x5.3mm_P1.27mm
U17: AD9850; SSOP-28_5.3x10.2mm_P0.65mm
U18: AD9744; TSSOP-28_4.4x9.7mm_P0.65mm
U19, U20, U25: LM6171; SOIC-8_3.9x4.9mm_P1.27mm
U21, U26: TMUX6104; TSSOP-14_4.4x5mm_P0.65mm
U22: TPL0401B-10; Texas_R-PDSO-G6
U23: THS3491; Texas_R-PDSO-G8_EP2.95x4.9mm_Mask2.4x3.1mm
X1: ASE-10.000MHz; Oscillator_SMD_Abracon_ASE-4Pin_3.2x2.5mm
X2: ASE-100.000MHz; Oscillator_SMD_Abracon_ASE-4Pin_3.2x2.5mm
Y1: 32.768k; Crystal_SMD_3215-2Pin_3.2x1.5mm
Y2: 12 MHz; Crystal_SMD_3225-4Pin_3.2x2.5mm

Connections:
1P2V_D: C13.1, C66.1, C69.1, R41.1, U5.5 (OUT), U12.5 (VCC), U12.30 (VCC)
1P8V_D: C77.1, C79.1, C80.1, C81.1, U14.12 (VCORE), U14.37 (VCORE), U14.49 (VREGOUT), U14.64 (VCORE)
2P5V_D: C14.1, C63.1, C64.1, U6.5 (OUT), U12.24 (VPP_2V5)
3P3V_A: C10.1, C47.1, C49.1, C88.1, C89.1, C92.1, C103.1, R88.1, U3.5 (OUT), U11.33 (VDDA), U17.11 (AVDD), U17.18 (AVDD), U18.24 (AVDD), U22.1 (VDD)
3P3V_D: C9.1, C35.1, C36.1, C40.1, C41.1, C42.1, C44.1, C46.1, C48.1, C50.1, C51.1, C52.1, C53.1, C54.1, C55.1, C56.1, C57.1, C58.1, C71.1, C82.1, C83.1, C84.1, C85.1, C86.1, C87.1, C90.1, C91.1, C94.1, FB1.1, FB2.1, J5.1, L3.1, L4.1, R1.2, R2.2, R3.2, R22.2, R24.2, R25.2, R30.1, R31.2, R33.1, R38.1, R39.1, R40.1, R42.1, R43.1, R45.1, R46.1, R52.1, R53.1, R54.2, R55.2, R56.2, R57.2, R76.2, R77.2, U2.2 (VO), U4.3 (EN), U9.2 (VDD), U10.6 (VDD), U11.6 (VBAT), U11.17 (VDD), U11.30 (VDD), U11.32 (VREF+), U11.39 (VDD), U11.52 (VDD), U11.62 (VDD), U11.72 (VDD), U11.84 (VDD), U11.95 (VDDUSB), U11.108 (VDD), U11.121 (VDD), U11.131 (VDD), U11.144 (VDD), U13.6 (VCC), U14.20 (VCCIO), U14.31 (VCCIO), U14.42 (VCCIO), U14.50 (VREGIN), U14.56 (VCCIO), U15.8 (VCC), U16.8 (VCC), U17.6 (DVDD), U17.23 (DVDD), U18.27 (DVDD)
3P3V_D_FPGA: C8.1, C59.1, C60.1, C61.1, C62.1, C65.1, C68.1, R35.2, R36.2, R37.2, U1.5 (OUT), U12.1 (VCCIO_2), U12.22 (SPI_VCCIO1), U12.33 (VCCIO_0)
5P0V: C1.1, C2.1, C3.1, C4.1, C5.1, C6.1, C7.1, C11.1, C12.1, C15.1, C28.1, J1.A4 (VBUS), J1.A9 (VBUS), J1.B4 (VBUS), J1.B9 (VBUS), L1.1, R4.2, R5.1, R48.1, U1.1 (IN), U2.3 (VI), U3.1 (IN), U3.3 (EN), U4.1 (VCC), U5.1 (IN), U6.1 (IN), U7.5 (INN), U7.6 (INN), U8.1 (VCC)
15P0V_A: C97.1, C98.1, C101.1, C105.1, C108.1, C111.1, C113.1, R16.1, U19.7 (V+), U20.7 (V+), U21.12 (VDD), U23.7 (V+), U24.2 (VDD), U25.7 (V+), U26.12 (VDD)
ANALOG_CAL-ADC_AMUX2_MCU: C106.2, C109.1, R82.1, R83.2, U11.42 (PA6)
ANALOG_DAC1_MCU_AMUX1: U11.40 (PA4), U21.11 (S3)
ANALOG_DAC2_MCU_AMUX3: R87.2, U11.41 (PA5), U26.4 (S1)
ANALOG_DC-OFFSET_AMUX3_AMP3: R78.1, U21.6 (D), U26.6 (D)
ANALOG_DDS_AMP2_AMUX1: R74.2, U21.5 (S2)
ANALOG_DDS_OUT_N: C96.2, R64.2, R68.1, U17.20 (IOUTB)
ANALOG_DDS_OUT_P: C96.1, R62.2, R67.1, U17.21 (IOUT)
ANALOG_FPGA-DAC_AMP1_AMUX1: R73.2, U21.4 (S1)
ANALOG_FPGA-DAC_OUT_N: C95.2, R63.2, R66.1, U18.21 (IOUTB)
ANALOG_FPGA-DAC_OUT_P: C95.1, R61.2, R65.1, U18.22 (IOUTA)
ANALOG_STAGE-2_AMUX2_EXT: C110.2, J4.1 (In), R86.1
CLK_10MHZ_DIST_EXT_3P3: C37.2, J3.1 (In), R25.1, R26.2, R29.1
CLK_10MHZ_DIST_FPGA_3P3: R28.1, U12.35 (IOT_46b_G0)
CLK_10MHZ_DIST_MCU_3P3: R27.1, U11.23 (PH0)
CLK_10MHZ_EXT_SW_3P3: J2.1 (In), U9.5 (SB)
CLK_100MHZ_DDS_3P3: R21.1, U17.9 (CLKIN)
GND: C1.2, C2.2, C3.2, C4.2, C5.2, C6.2, C7.2, C8.2, C9.2, C10.2, C11.2, C12.2, C13.2, C14.2, C15.2, C16.2, C17.2, C18.2, C20.2, C22.2, C23.2, C24.2, C25.2, C26.2, C27.2, C28.2, C29.2, C30.2, C31.2, C32.2, C33.2, C34.2, C35.2, C36.2, C37.1, C38.2, C39.2, C40.2, C41.2, C42.2, C43.2, C44.2, C45.2, C46.2, C47.2, C48.2, C49.2, C50.2, C51.2, C52.2, C53.2, C54.2, C55.2, C56.2, C57.2, C58.2, C59.2, C60.2, C61.2, C62.2, C63.2, C64.2, C65.2, C66.2, C67.2, C68.2, C69.2, C70.2, C71.2, C72.2, C73.2, C74.2, C75.2, C76.2, C77.2, C78.2, C79.2, C80.2, C81.2, C82.2, C83.2, C84.2, C85.2, C86.2, C87.2, C88.2, C89.2, C90.2, C91.2, C92.2, C93.2, C94.2, C97.2, C98.2, C99.2, C100.2, C101.2, C102.2, C103.2, C104.2, C105.2, C106.1, C107.2, C108.2, C110.1, C111.2, C112.2, C113.2, C114.2, D1.1 (K), H1.1, H2.1, H3.1, H4.1, J1.A1 (GND), J1.A12 (GND), J1.B1 (GND), J1.B12 (GND), J1.S1 (SHIELD), J2.2 (Ext), J3.2 (Ext), J4.2 (Ext), J5.3, J5.5, J5.7, J5.9, L2.1, R9.2, R23.1, R26.1, R32.2, R34.1, R47.2, R49.2, R58.2, R59.2, R60.2, R61.1, R62.1, R63.1, R64.1, R69.1, R70.1, R75.1, R80.1, R82.2, R84.1, R89.1, R92.1, R93.1, R94.1, SW1.C1 (NO_1), SW1.D1 (NO_2), U1.2 (GND), U2.1 (GND), U3.2 (GND), U4.2 (GND), U5.2 (GND), U6.2 (GND), U7.2 (PGND), U7.3 (PGND), U7.19 (AGND), U7.25 (EP), U8.4 (GND), U9.3 (GND), U9.4 (VSS), U10.4 (GND), U11.16 (VSS), U11.31 (VSSA), U11.38 (VSS), U11.51 (VSS), U11.61 (VSS), U11.83 (VSS), U11.94 (VSS), U11.107 (VSS), U11.120 (VSS), U11.130 (VSS), U12.49 (GND), U13.2 (VSS), U14.1 (GND), U14.5 (GND), U14.10 (AGND), U14.11 (GND), U14.13 (TEST), U14.15 (GND), U14.25 (GND), U14.35 (GND), U14.47 (GND), U14.51 (GND), U15.4 (GND), U16.4 (GND), U17.5 (DGND), U17.10 (AGND), U17.19 (AGND), U17.24 (DGND), U18.16 (REFLO), U18.20 (AGND), U18.26 (DGND), U21.10 (S4), U21.13 (GND), U22.2 (GND), U23.1 (REF), U23.9 (EP), U24.4 (VSS), U26.11 (S3), U26.13 (GND), X1.2 (GND), X2.2 (GND), Y2.2, Y2.4
GPIO_1P2-EN_SEQ_REG_3P3: R1.1, U4.6 (FLAG1), U5.3 (EN)
GPIO_2P5-EN_SEQ_REG_3P3: R3.1, U4.4 (FLAG3), U6.3 (EN)
GPIO_3P3-EN_SEQ_REG_3P3: R2.1, U1.3 (EN), U4.5 (FLAG2)
GPIO_100M-EN_MCU_100M-OSC_3P3: R20.1, U11.73 (PB12), X2.1 (EN)
GPIO_AMP-PD_MCU_AMP2_3P3: U11.55 (PF15), U23.8 (~PD)
GPIO_BOOT0_SW_MCU_3P3_L: R31.1, R32.1, U11.138 (BOOT0)
GPIO_BOOT1_SW_MCU_3P3_L: R33.2, R34.2, R54.1, U11.48 (PB2), U15.6 (CLK)
GPIO_CFG_DONE_FPGA_MCU_3P3: R35.1, U11.49 (PF11), U12.7 (CDONE)
GPIO_CLK_EN_MCU_FPGA_3P3: U11.54 (PF14), U12.37 (IOT_45a_G1)
GPIO_D0_MCU_DDS_3P3: U11.88 (PG3), U17.4 (D0)
GPIO_D1_MCU_DDS_3P3: U11.80 (PD11), U17.3 (D1)
GPIO_D2_MCU_DDS_3P3: U11.81 (PD12), U17.2 (D2)
GPIO_D3_MCU_DDS_3P3: U11.103 (PA11), U17.1 (D3)
GPIO_D4_MCU_DDS_3P3: U11.79 (PD10), U17.28 (D4)
GPIO_D5_MCU_DDS_3P3: U11.78 (PD9), U17.27 (D5)
GPIO_D6_MCU_DDS_3P3: U11.77 (PD8), U17.26 (D6)
GPIO_D7_MCU_DDS_3P3: U11.76 (PB15), U17.25 (D7)
GPIO_DACB0_FPGA_DAC_3P3: U12.25 (IOT_36b), U18.14 (D0)
GPIO_DACB1_FPGA_DAC_3P3: U12.26 (IOT_39a), U18.13 (D1)
GPIO_DACB2_FPGA_DAC_3P3: U12.27 (IOT_38b), U18.12 (D2)
GPIO_DACB3_FPGA_DAC_3P3: U12.28 (IOT_41a), U18.11 (D3)
GPIO_DACB4_FPGA_DAC_3P3: U12.31 (IOT_42b), U18.10 (D4)
GPIO_DACB5_FPGA_DAC_3P3: U12.34 (IOT_44b), U18.9 (D5)
GPIO_DACB6_FPGA_DAC_3P3: U12.36 (IOT_48b), U18.8 (D6)
GPIO_DACB7_FPGA_DAC_3P3: U12.38 (IOT_50b), U18.7 (D7)
GPIO_DACB8_FPGA_DAC_3P3: U12.42 (IOT_51a), U18.6 (D8)
GPIO_DACB9_FPGA_DAC_3P3: U12.43 (IOT_49a), U18.5 (D9)
GPIO_DACB10_FPGA_DAC_3P3: U12.48 (IOB_4a), U18.4 (D10)
GPIO_DACB11_FPGA_DAC_3P3: U12.12 (IOB_22a), U18.3 (D11)
GPIO_DACB12_FPGA_DAC_3P3: U12.45 (IOB_5b), U18.2 (D12)
GPIO_DACB13_FPGA_DAC_3P3: U12.44 (IOB_3b_G6), U18.1 (D13)
GPIO_DACCLK_FPGA_DAC_3P3: U12.47 (IOB_2a), U18.28 (CLK)
GPIO_DACSLEEP_FPGA_DAC_3P3: U12.13 (IOB_24a), U18.15 (SLEEP)
GPIO_EN_MCU_AMUX1_3P3: R75.2, U11.127 (PG12), U21.2 (EN)
GPIO_EN_MCU_AMUX2_3P3: R84.2, U11.66 (PE13), U24.1 (EN)
GPIO_EN_MCU_AMUX3_3P3: R92.2, U11.64 (PE11), U26.2 (EN)
GPIO_FPGARST_MCU_FPGA_3P3_L: R36.1, U11.50 (PF12), U12.8 (~CRESET)
GPIO_FQ-UD_MCU_DDS_3P3: U11.87 (PG2), U17.8 (FQ_UD)
GPIO_LED0_FPGA_LED_OD: D4.1 (K), U12.39 (RGB0)
GPIO_LED1_FPGA_LED_OD: D5.1 (K), U12.40 (RGB1)
GPIO_LED2_FPGA_LED_OD: D6.1 (K), U12.41 (RGB2)
GPIO_RST_MCU_3P3_L: SW1.A1 (COM_1), U11.25 (NRST)
GPIO_RST_MCU_DDS_3P3: U11.75 (PB14), U17.22 (RESET)
GPIO_SEL0_MCU_AMUX1_3P3: U11.123 (PD7), U21.1 (A0)
GPIO_SEL0_MCU_AMUX3_3P3: U11.65 (PE12), U26.1 (A0)
GPIO_SEL1_MCU_AMUX1_3P3: U11.122 (PD6), U21.14 (A1)
GPIO_SEL1_MCU_AMUX3_3P3: U11.43 (PA7), U26.14 (A1)
GPIO_SEL_MCU_AMUX2_3P3: U11.67 (PE14), U24.8 (IN)
GPIO_SW-SEL_MCU_CLKMUX_3P3: R23.2, U9.8 (IN), U11.112 (PC11)
GPIO_UART_RXLED_FTDI_L: D7.1 (K), U14.29 (ACBUS3)
GPIO_UART_TXLED_FTDI_L: D8.1 (K), U14.30 (ACBUS4)
GPIO_W-CLK_MCU_DDS_3P3: U11.104 (PA12), U17.7 (W_CLK)
I2C_SCL_MCU_POT_3P3: R77.1, U11.69 (PB10), U22.3 (SCL)
I2C_SDA_MCU_POT_3P3: R76.1, U11.70 (PB11), U22.4 (SDA)
JTAG_CON_TCK_3P3: J5.4, R96.2
JTAG_CON_TDI_3P3: J5.8, R100.2
JTAG_CON_TDO_3P3: J5.6, R102.2
JTAG_CON_TMS_3P3: J5.2, R98.2
JTAG_FTDI_TCK_3P3: R95.2, U14.38 (BDBUS0)
JTAG_FTDI_TDI_3P3: R99.2, U14.39 (BDBUS1)
JTAG_FTDI_TDO_3P3: R101.2, U14.40 (BDBUS2)
JTAG_FTDI_TMS_3P3: R97.2, U14.41 (BDBUS3)
JTAG_MCU_TCK_3P3: R95.1, R96.1, U11.109 (PA14)
JTAG_MCU_TDI_3P3: R99.1, R100.1, U11.110 (PA15)
JTAG_MCU_TDO_3P3: R101.1, R102.1, U11.133 (PB3)
JTAG_MCU_TMS_3P3: R97.1, R98.1, U11.105 (PA13)
N15P0V_A: C99.1, C100.1, C102.1, C104.1, C107.1, C112.1, C114.1, R17.1, U19.4 (V-), U20.4 (V-), U21.3 (VSS), U23.4 (V-), U24.3 (GND), U25.4 (V-), U26.3 (VSS)
unnamed: C17.1, R6.2
unnamed: C18.1, R10.2
unnamed: C19.1, R11.2
unnamed: C21.2, R14.1
unnamed: D1.2 (A), R4.1
unnamed: D2.2 (A), L1.2, U7.1 (INP), U7.24 (INP)
unnamed: C22.1, C24.1, C26.1, C29.1, C31.1, D2.1 (K), R7.1, R16.2, U7.23 (VPOS)
unnamed: C23.1, C25.1, C27.1, C30.1, C32.1, D3.2 (A), R15.2, R17.2, U7.15 (VNEG)
unnamed: D3.1 (K), L2.2, U7.13 (OUTN), U7.14 (OUTN)
unnamed: D4.2 (A), R38.2
unnamed: D5.2 (A), R39.2
unnamed: D6.2 (A), R40.2
unnamed: D7.2 (A), R52.2
unnamed: D8.2 (A), R53.2
unnamed: D9.1 (A), R85.2
unnamed: C109.2, D9.3 (K), R83.1
unnamed: J1.A5 (CC1), R94.2
unnamed: J1.B5 (CC2), R93.2
unnamed: R7.2, R8.1, R11.1
unnamed: R13.2, R14.2, R15.1
unnamed: R71.2, R73.1, U19.6
unnamed: R72.2, R74.1, U20.6
unnamed: R78.2, R79.1
unnamed: R90.2, R91.1, U25.6
unnamed: R10.1, U7.18 (CN)
unnamed: R6.1, U7.21 (CP)
unnamed: C16.1, R5.2, U7.4 (VIN), U7.8 (ENP), U7.9 (PSP), U7.10 (ENN), U7.11 (PSN)
unnamed: C21.1, R12.2, R13.1, U7.16 (FBN)
unnamed: C19.2, R8.2, R9.1, U7.22 (FBP)
unnamed: C20.1, R12.1, U7.17 (VREF)
unnamed: R22.1, U9.1 (EN)
unnamed: R19.1, U9.7 (SA)
unnamed: R24.1, U10.2 (1G)
unnamed: U9.6 (D), U10.1 (CLKIN)
unnamed: R27.2, U10.3 (Y0)
unnamed: R28.2, U10.8 (Y1)
unnamed: R29.2, U10.5 (Y2)
unnamed: C45.1, U11.8 (PC14), Y1.2
unnamed: C43.1, U11.9 (PC15), Y1.1
unnamed: R30.2, U11.143 (PDR_ON)
unnamed: C38.1, U11.71 (VCAP_1)
unnamed: C39.1, U11.106 (VCAP_2)
unnamed: C67.1, C70.1, R41.2, U12.29 (VCCPLL)
unnamed: R46.2, U13.4 (CLK), U14.62 (EECLK)
unnamed: R45.2, U13.5 (CS), U14.63 (EECS)
unnamed: R44.1, U13.3 (DI), U14.61 (EEDATA)
unnamed: R43.2, R44.2, U13.1 (DO)
unnamed: R50.1, U14.16 (ADBUS0)
unnamed: R51.1, U14.17 (ADBUS1)
unnamed: R48.2, R49.1, U14.59 (BCBUS7)
unnamed: C73.1, U14.2 (OSCI), Y2.1
unnamed: C75.1, U14.3 (OSCO), Y2.3
unnamed: R47.1, U14.6 (REF)
unnamed: C72.1, C76.1, L3.2, U14.4 (VPHY)
unnamed: C74.1, C78.1, L4.2, U14.9 (VPLL)
unnamed: R42.2, U14.14 (~RESET)
unnamed: R58.1, U17.12 (RSET)
unnamed: R59.1, U18.18 (FS_ADJ)
unnamed: R60.1, U18.25 (MODE)
unnamed: C93.1, U18.17 (REFIO)
unnamed: R65.2, R71.1, U19.3 (+)
unnamed: R66.2, R69.2, U19.2 (-)
unnamed: R67.2, R72.1, U20.3 (+)
unnamed: R68.2, R70.2, U20.2 (-)
unnamed: R81.1, U22.6 (H)
unnamed: U22.5 (W), U23.6, U24.6 (D)
unnamed: R80.2, U23.3 (+)
unnamed: R79.2, R81.2, U23.2 (-)
unnamed: R86.2, U24.7 (SA)
unnamed: R85.1, U24.5 (SB)
unnamed: R87.1, R90.1, U25.3 (+)
unnamed: R88.2, R89.2, U25.2 (-)
unnamed: R91.2, U26.5 (S2)
unnamed: R18.1, X1.1 (EN)
unnamed: R19.2, X1.3 (OUT)
unnamed: C33.1, FB1.2, R18.2, X1.4 (Vdd)
unnamed: R21.2, X2.3 (OUT)
unnamed: C34.1, FB2.2, R20.2, X2.4 (Vdd)
QSPI_IO0_MCU_FLASH_3P3: U11.20 (PF8), U15.5 (DI(IO0))
QSPI_IO1_MCU_FLASH_3P3: U11.21 (PF9), U15.2 (DO(IO1))
QSPI_IO2_MCU_FLASH_3P3: U11.1 (PE2), U15.3 (IO2)
QSPI_IO3_MCU_FLASH_3P3: U11.18 (PF6), U15.7 (IO3)
QSPI_NCS_MCU_FLASH_3P3: R56.1, U11.91 (PG6), U15.1 (~CS)
SPI_CS_MCU_FLASH_3P3_L: R57.1, U11.29 (PC3), U16.1 (~CS)
SPI_CS_MCU_FPGA_3P3_L: R37.1, U11.26 (PC0), U12.16 (IOB_35b_SPI_SS)
SPI_MISO_FPGA_MCU_3P3: U11.28 (PC2), U12.14 (IOB_32a_SPI_SO), U16.2 (DO(IO1))
SPI_MOSI_MCU_FPGA_3P3: U11.27 (PC1), U12.17 (IOB_33b_SPI_SI), U16.5 (DI(IO0))
SPI_SCLK_MCU_FPGA_3P3: R55.1, U11.74 (PB13), U12.15 (IOB_34a_SPI_SCK), U16.6 (CLK)
UART_FTDITX_MCURX_3P3: R50.2, U11.37 (PA3)
UART_MCUTX_FTDIRX_3P3: R51.2, U11.36 (PA2)
USB_DATA_CONN_FTDI_N: J1.A7 (D-), J1.B7 (D-), U8.5 (D-), U14.7 (DM)
USB_DATA_CONN_FTDI_P: J1.A6 (D+), J1.B6 (D+), U8.3 (D+), U14.8 (DP)
