brzyzek/arb/3_SOFTWARE/arb/arb.ioc

Mcu.UserName=STM32F446ZETx
PA11.Signal=GPIO_Output
PA12.Signal=GPIO_Output
PA13.Signal=SYS_JTMS-SWDIO
PA14.Signal=SYS_JTCK-SWCLK
PA15.Signal=SYS_JTDI
PA2.Signal=USART2_TX
PA3.Signal=USART2_RX
PA4.Signal=COMP_DAC1_group
PA5.Signal=COMP_DAC2_group
PA6.Signal=ADCx_IN6
PA7.Signal=GPIO_Output
PB10.Signal=I2C2_SCL
PB11.Signal=I2C2_SDA
PB12.Signal=GPIO_Output
PB13.Signal=SPI2_SCK
PB14.Signal=GPIO_Output
PB15.Signal=GPIO_Output
PB2.Signal=QUADSPI_CLK
PB3.Signal=SYS_JTDO-SWO
PC0.Signal=GPIO_Output
PC1.Signal=SPI2_MOSI
PC11.Signal=GPIO_Output
PC14-OSC32_IN.Signal=RCC_OSC32_IN
PC15-OSC32_OUT.Signal=RCC_OSC32_OUT
PC2.Signal=SPI2_MISO
PC3.Signal=GPIO_Output
PD10.Signal=GPIO_Output
PD11.Signal=GPIO_Output
PD12.Signal=GPIO_Output
PD6.Signal=GPIO_Output
PD7.Signal=GPIO_Output
PD8.Signal=GPIO_Output
PD9.Signal=GPIO_Output
PE11.Signal=GPIO_Output
PE12.Signal=GPIO_Output
PE13.Signal=GPIO_Output
PE14.Signal=GPIO_Output
PE2.Signal=QUADSPI_BK1_IO2
PF11.Signal=GPIO_Input
PF12.Signal=GPIO_Output
PF14.Signal=GPIO_Output
PF15.Signal=GPIO_Output
PF6.Signal=QUADSPI_BK1_IO3
PF8.Signal=QUADSPI_BK1_IO0
PF9.Signal=QUADSPI_BK1_IO1
PG12.Signal=GPIO_Output
PG2.Signal=GPIO_Output
PG3.Signal=GPIO_Output
PG6.Signal=QUADSPI_BK1_NCS
PH0-OSC_IN.Signal=RCC_OSC_IN
