brzyzek/arb/(commit log)

2024-09-03 FEAT: Modified Block Diagram /w new Layout (& FPGA), added BOM Template.
    [brzk-arb-001-BOM.ods]
2024-09-12 MINOR: Setup KiCAD Template.
    [arb.kicad_pcb, arb.kicad_sch, blank_template.kicad_sch, brzk-arb-001-BOM.ods, clocking.kicad_sch, connectors.kicad_sch, power.kicad_sch]
2024-09-12 MINOR: Added KiCAD Custom Symbol and Footprint Pointers.
2024-09-16 FEAT: Modified Block Diagram. Added Pin Map Excel.
    [ARB_PIN_MAP.ods, arb.kicad_sch, blank_template.kicad_sch, clocking.kicad_sch, connectors.kicad_sch, fpga.kicad_sch, ftdi.kicad_sch, microprocessor.kicad_sch]
2024-09-17 FEAT: Added Level Translator Sheet, Symbols, added DAC and DDS to Schematic.
    [ARB_PIN_MAP.ods, arb.kicad_sch, dac.kicad_sch, lvl_trns.kicad_sch]
2024-09-22 FEAT: Finished Excel Pin Map for FPGA.
    [ARB_PIN_MAP.ods]
2024-09-28 FEAT: Finished Excel Pin Map for MCU. Completed MCU + FPGA in Schematic.
    [ARB_PIN_MAP.ods, dac.kicad_sch, fpga.kicad_sch, ftdi.kicad_sch, microprocessor.kicad_sch, power_seq.kicad_sch]
2024-09-28 FEAT: Added FTDI JTAG. Added 0 Ohm JTAG Resistors. Added Boot Select Switches.
    [connectors.kicad_sch, ftdi.kicad_sch, microprocessor.kicad_sch]
2024-09-30 MINOR: Updated Block Diagram with preliminary post DAC stage analog design.
    [dac.kicad_sch]
2024-10-12 FEAT: Simulated Analog Paths, added first stage analog amp to schematic.
    [OP_AMPS.ods, analog1.kicad_sch, analog2.kicad_sch, analogdc.kicad_sch, arb.kicad_sch, clocking.kicad_sch, connectors.kicad_sch, dac.kicad_sch]
2024-10-18 FEAT: Added Analog Stage 2 to Schematic. Some additional symbols (Pot, SPDT Analog MUX, etc.) added to Project.
    [analog1.kicad_sch, analog2.kicad_sch, analogdc.kicad_sch, dac.kicad_sch, ftdi.kicad_sch, microprocessor.kicad_sch]
2024-10-19 FEAT: Added RVP Diode + Attenuation on the Cal Path.
    [analog1.kicad_sch, analog2.kicad_sch]
2024-10-21 FEAT: Swapped out DDS IC and connected. Started adding Clockign Components into Schematic.
    [analog1.kicad_sch, clocking.kicad_sch, dac.kicad_sch, microprocessor.kicad_sch]
2024-10-27 FEAT: Created Power Consumption Matrix.
    [POWER_ANALYSIS.ods, arb.csv, arb.kicad_sch, dac.kicad_sch, ftdi.kicad_sch]
2024-10-28 FEAT: Added MCU Resources for Analog Muxing, Additional DAC, ADC, and I2C for Digital Pot. Also changed SPI Resource from 1 to 2.
    [ARB_PIN_MAP.ods, fpga.kicad_sch, ftdi.kicad_sch, ioc_out.csv, microprocessor.kicad_sch]
2024-10-28 FEAT: Changed from two grounds (Digital + Analog) to Singular Ground IAW recommended Grounding Scheme.
    [analog1.kicad_sch, analog2.kicad_sch, analogdc.kicad_sch, dac.kicad_sch, fpga.kicad_sch, ftdi.kicad_sch, microprocessor.kicad_sch]
2024-10-28 MINOR: Updated Pin Map with new MCU Resources and filled out STM32 .ioc file with GPIO In/Out and all Resources.
    [ARB_PIN_MAP.ods, ioc_out.csv]
2024-11-03 FEAT: Added +15V and -15V Regulator. Replaced some Symbols to add additional Part Number Field.
    [analog1.kicad_sch, analog2.kicad_sch, analogdc.kicad_sch, clocking.kicad_sch, dac.kicad_sch, ftdi.kicad_sch, microprocessor.kicad_sch, power.kicad_sch]
2024-11-05 FEAT: Added USB ESD Protection.
    [POWER_ANALYSIS.ods, arb.kicad_sch, fpga.kicad_sch, power.kicad_sch, power_seq.kicad_sch]
2024-11-09 FEAT: Added Clocking Sheet, FPGA Flash, and FPGA Decoupling.
    [ARB_PIN_MAP.ods, analog2.kicad_sch, analogdc.kicad_sch, clocking.kicad_sch, connectors.kicad_sch, fpga.kicad_sch, microprocessor.kicad_sch, power.kicad_sch]
2024-11-10 FEAT: Added Connectors on Schematic. Created Connector Footprints.
    [analog1.kicad_sch, analog2.kicad_sch, analogdc.kicad_sch, clocking.kicad_sch, connectors.kicad_sch, dac.kicad_sch, fpga.kicad_sch, ftdi.kicad_sch]
2024-11-10 FEAT: Assigned Reference Designators; Assigned Passives Part Numbers & Footprints (0603); Assigned LCSC P/Ns.
    [analog1.kicad_sch, analog2.kicad_sch, analogdc.kicad_sch, arb.kicad_sch, clocking.kicad_sch, connectors.kicad_sch, dac.kicad_sch, fpga.kicad_sch]
2024-11-11 FEAT: Added MCU Flash. Finished creating & assigning footprints. Ran ERC & cleared out issues. Ready for Layout.
    [analog1.kicad_sch, analog2.kicad_sch, analogdc.kicad_sch, arb.kicad_sch, clocking.kicad_sch, connectors.kicad_sch, dac.kicad_sch, flash.kicad_sch]
2024-11-16 MINOR: Verified Footprints to Datasheets. Added Pull Ups on FPGA DONE/Config/SPI Chip Select Pins.
    [analog1.kicad_sch, analog2.kicad_sch, analogdc.kicad_sch, arb.csv, connectors.kicad_sch, dac.kicad_sch, flash.kicad_sch, footprint_verification_20241116.ods]
2024-11-17 MINOR: Added Board Rules & Constraints.
    [arb.kicad_pcb, connectors.kicad_sch, fpga.kicad_sch, power.kicad_sch]
2024-11-22 FEAT: Initial board placement started.
    [analog1.kicad_sch, analog2.kicad_sch, analogdc.kicad_sch, arb.kicad_pcb, connectors.kicad_sch, dac.kicad_sch, flash.kicad_sch, ftdi.kicad_sch]
2024-11-23 FEAT: Finished placement of components, switches, etc.
    [arb.kicad_pcb, microprocessor.kicad_sch]
2024-11-24 MINOR: Started laying out signal tracks. About 1/4th of the way done. Started on Digital, 3P3V Power, Clocking.
    [arb.kicad_pcb]
2024-11-26 FEAT: Changed Inductor to higher current. Continued layout. Assigned some Netclasses.
    [POWER_ANALYSIS.ods, analog1.kicad_sch, analog2.kicad_sch, analogdc.kicad_sch, arb.kicad_pcb, connectors.kicad_sch, dac.kicad_sch, power.kicad_sch]
2024-11-27 FEAT: Laid out some more analog. Laid out FPGA and DDC ICs.
    [arb.kicad_pcb]
2024-11-28 FEAT: Laid out JTAG, Processor QSPI. Length Matched JTAG.
    [arb.kicad_pcb]
2024-11-30 FEAT: Laid out MCU DDS. Changed some MCU Pins for better routability.
    [ARB_PIN_MAP.ods, arb.kicad_pcb, microprocessor.kicad_sch]
2024-12-01 MINOR: Laid out +/- 15V Regulator. Some Discrete Signals.
    [arb.kicad_pcb]
2024-12-19 MINOR: Some minor trace adjustments. Ran trace cleanup tool.
2024-12-21 MINOR: Removed all existing Vias and Tracks.
    [arb.kicad_pcb]
2024-12-21 FEAT: Placed components for Left-Handed Analog Output.
    [arb.kicad_pcb]
2024-12-22 FEAT: Placed most components for Right-Handed Analog Output.
    [arb.kicad_pcb]
2024-12-22 FEAT: Added some Power Planes for 3.3V, 5V. Routed 50 Ohm Analog and Differential.
    [arb.kicad_pcb]
2024-12-23 MINOR: Continuing layout. USB, Some FTDI, etc.
    [arb.kicad_pcb]
2024-12-28 MINOR: Continuing layout. Laid Out FPGA Power.
    [arb.kicad_pcb]
2024-12-28 MINOR: Layout. 3.3V Analog Power, FTDI IC. Clocks.
    [ARB_PIN_MAP.ods, arb.kicad_pcb, microprocessor.kicad_sch]
2024-12-29 MINOR: Layout. Grounds. Misc.
    [arb.kicad_pcb]
2024-12-30 FEAT: Finished with Power and GND Layout.
    [arb.kicad_pcb]
2024-12-31 MINOR: Layout, JTAG complete.
    [ARB_PIN_MAP.ods, arb.kicad_pcb]
2025-01-01 MINOR: Layout, I2C Potentiometer, QSPI MCU Memory.
    [ARB_PIN_MAP.ods, arb.kicad_pcb, microprocessor.kicad_sch]
2025-01-01 MINOR: Layout, working on SPI / QSPI. Currently mixed up.
    [ARB_PIN_MAP.ods, arb.kicad_pcb, microprocessor.kicad_sch]
2025-01-01 MINOR: Layout, working on SPI / QSPI. Fixed issues with Schematic.
    [arb.kicad_pcb, microprocessor.kicad_sch]
2025-01-02 FEAT: Finished DDS, MCU Layout.
    [analogdc.kicad_sch, arb.kicad_pcb, microprocessor.kicad_sch]
2025-01-03 FEAT: Started FPGA Layout, 1/2 Complete.
    [arb.kicad_pcb, fpga.kicad_sch]
2025-01-04 FEAT: Completed FPGA Layout.
    [arb.kicad_pcb, fpga.kicad_sch]
2025-01-04 MINOR: Adjusted Pin Map per new Layout.
    [ARB_PIN_MAP.ods, arb.kicad_pcb, fpga.kicad_sch, microprocessor.kicad_sch]
2025-01-05 FEAT: Updated STM32 IOC to Match new Pinout.
2025-01-05 FEAT: Removed Chassis GND, completed routing. Needs to be verified.
    [arb.kicad_pcb, connectors.kicad_sch, microprocessor.kicad_sch, power.kicad_sch]
2025-01-08 FIX: Resolved Edge Cut issue. Resolved all DRC Errors. Updated minimum annular ring from .2mm to 0.15mm.
    [arb.kicad_pcb]
2025-01-11 MINOR: Changed Via Sizes from 7/3.5mm to 7/3mm.
    [arb.kicad_pcb]
2025-01-12 FEAT: Fixed Regulator Layouts. Added Stitching Vias around the outside. Started adding stitching Vias throughout the IC.
    [arb.kicad_pcb]
2025-01-12 Fixed: Added more stitching VIAs. Fixed outline trace conflicts. Resolved DRC Errors.
    [arb.kicad_pcb]
2025-01-12 FIX: Fixed 100MHz Clock Routing. Added some via guard rings, fixed Clock Trace Routing.
    [arb.kicad_pcb]
2025-01-19 MINOR: Adjusted 10MHz clock and vias.
    [arb.kicad_pcb]
2025-02-06 FIX: Refactoring folder structure.
    [ARB_PIN_MAP.ods, OP_AMPS.ods, POWER_ANALYSIS.ods, analog1.kicad_sch, analog2.kicad_sch, analogdc.kicad_sch, arb.csv, arb.kicad_pcb]
2025-02-08 FEAT: Added silkscreen.
    [arb.kicad_pcb]
2025-04-13 MINOR: Adjusted soldermask and ported Schematic + PCB to Kicad 9.0.
    [analog1.kicad_sch, analog2.kicad_sch, analogdc.kicad_sch, arb.kicad_pcb, arb.kicad_sch, blank_template.kicad_sch, clocking.kicad_sch, connectors.kicad_sch]
2025-07-16 MINOR: Adjusted Analog Schematic.
    [analog2.kicad_sch]
2025-07-16 MINOR: Adjusted schematic version.
    [analog1.kicad_sch, analog2.kicad_sch, analogdc.kicad_sch, arb.kicad_sch, blank_template.kicad_sch, clocking.kicad_sch, connectors.kicad_sch, dac.kicad_sch]
2025-07-19 MINOR: Initial Reduced Size Analysis, need to make the board larger.
    [arb.kicad_pcb]
2025-07-19 MINOR: Changed board outline and started component placement.
    [arb.kicad_pcb, connectors.kicad_sch]
2025-07-20 MINOR: Changed Boot Select Switches to Pull-Downs / Pull Up DNI and continued layout.
    [analog1.kicad_sch, analog2.kicad_sch, analogdc.kicad_sch, arb.kicad_pcb, clocking.kicad_sch, connectors.kicad_sch, dac.kicad_sch, flash.kicad_sch]
2025-07-27 MINOR: Completed initial placement.
    [arb.kicad_pcb]
2025-07-29 MINORL: Completed 3.3V Regulator Power Planes. Started on FTDI Clock.
    [arb.kicad_pcb, microprocessor.kicad_sch, power.kicad_sch]
2025-07-30 MINOR: Routed (most of) the clocks.
    [arb.kicad_pcb]
2025-07-31 MAJOR: Converted PCB from 4 Layer to 6 Layer, updated board stackup, and added new trace constraints. Updated all active traces on PCB to new widths.
    [arb.kicad_pcb]
2025-08-07 MINOR: Finalized Clock Routing & started on FTDI Chip Routing.
    [arb.kicad_pcb, ftdi.kicad_sch]
2025-08-09 MINOR: Finalized FTDI Chip Routing.
    [arb.kicad_pcb]
2025-08-11 MINOR: Added Power and GND Vias on the Top Layer.
    [arb.kicad_pcb, fpga.kicad_sch]
2025-08-13 MINOR: Routed Layer 3 Power Planes.
    [arb.kicad_pcb]
2025-08-24 MINOR: Added missing vias, started on BS Routing.
    [arb.kicad_pcb]
2025-08-25 MINOR: Adjusted Fill Clearances to 10 mil, continued with +/-15V Regulator Layout. Added First VIA in Pad.
    [arb.kicad_pcb]
2025-08-26 FEAT: Laid out +/-15V Regulator. Fixed input resistor into +/-15V Regulator Power. Named Power Planes.
    [arb.kicad_pcb]
2025-09-01 MINOR: Moved Analog Components for easier routing.
    [arb.kicad_pcb]
2025-09-03 FEAT: Completed Power Planes, GND, and Analog Placement.
    [arb.kicad_pcb]
2025-09-17 MINOR: Fixed Board Edge Cuts.
    [arb.kicad_pcb]
2025-09-21 FEAT: Repinned the MCU to better support new layout.
    [ARB_PIN_MAP.ods, arb.kicad_pcb, microprocessor.kicad_sch]
2025-09-21 FEAT: Routed FPGA to MCU SPI Connections.
    [arb.kicad_pcb]
2025-09-24 FEAT: Routed high speed signals.
    [arb.kicad_pcb]
2025-09-26 FEAT: Routed FPGA to DDS and FPGA to MCU Signals.
    [ARB_PIN_MAP.ods, arb.kicad_pcb, fpga.kicad_sch, microprocessor.kicad_sch]
2025-09-27 FEAT: Routed Analog and all Misc Signals. Routing is complete.
    [ARB_PIN_MAP.ods, analog2.kicad_sch, analogdc.kicad_sch, arb.kicad_pcb, connectors.kicad_sch]
2025-09-28 FEAT: Fixed Silkscreen + Resolved all DRC Errors.
    [arb.kicad_pcb, flash.kicad_sch, microprocessor.kicad_sch]
2025-10-04 FEAT: Removed Via in Pad from Design + added sitching vias.
    [arb.kicad_pcb, connectors.kicad_sch]
2025-10-12 FEAT: Created BOM.
    [arb-B_Cu.gbr, arb-B_Mask.gbr, arb-B_Paste.gbr, arb-B_Silkscreen.gbr, arb-Edge_Cuts.gbr, arb-F_Cu.gbr, arb-F_Mask.gbr, arb-F_Paste.gbr]
2025-10-13 MINOR: Adjusted Silkscreen.
    [arb.kicad_pcb]
